smdawson/Wilson2/doc/coupler_5x8.jpg

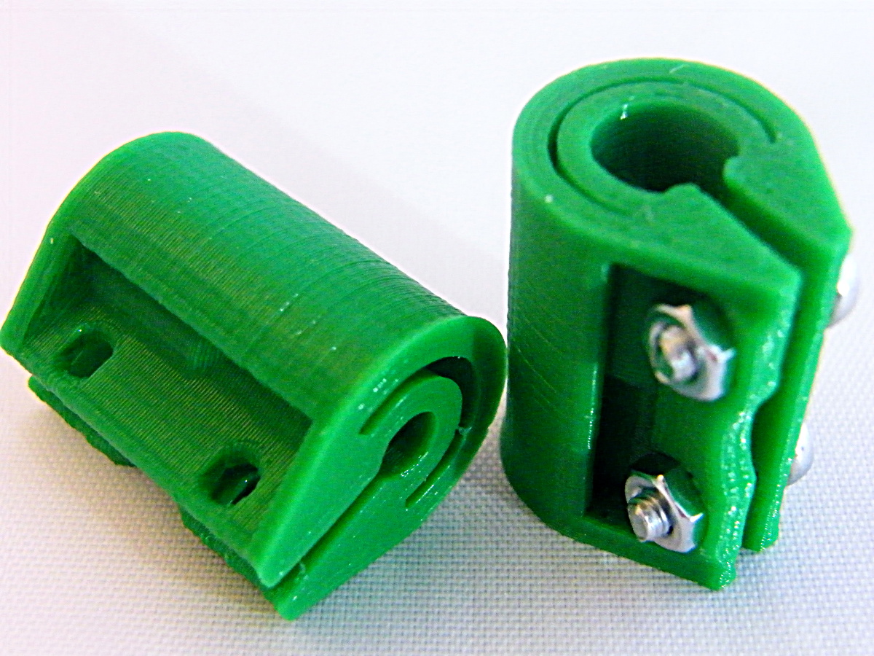
doc/coupler_5x8.jpg
