smdawson/Wilson2/doc/power_assy_1.jpg

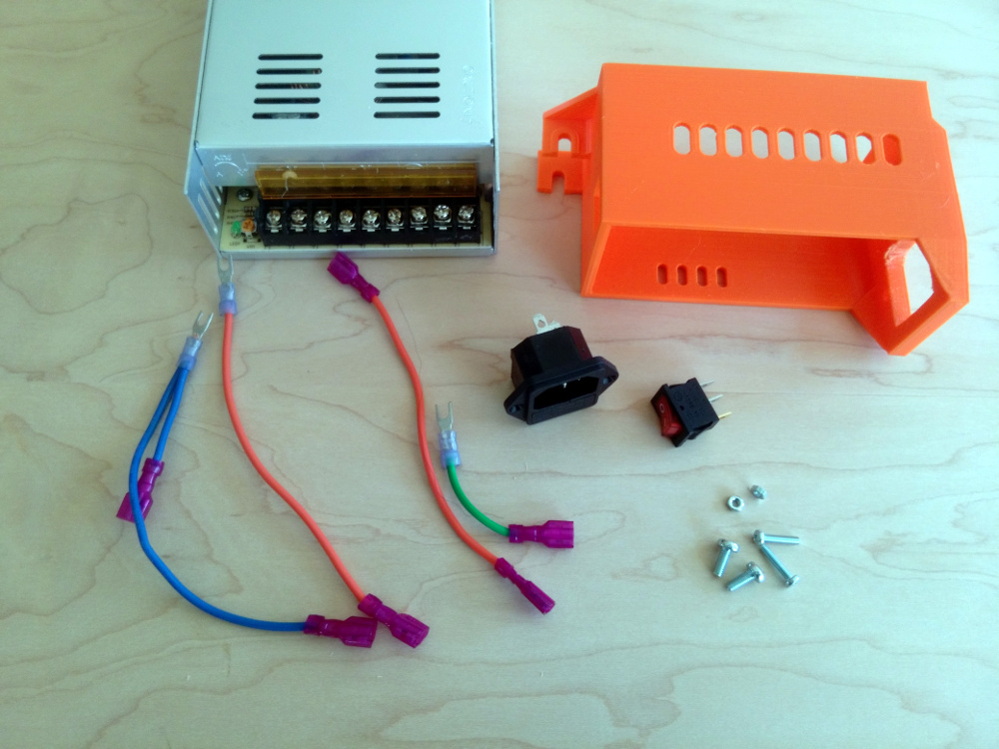
doc/power_assy_1.jpg
