smdawson/Wilson2/stl/alts-and-deprecated/readme.txt

/stl/alts-and-deprecated

The model files located in this folder are for 
rarely used alternate versions of some parts, or
deprecated models (things no longer recommended 
for the standard Wilson II build).
