smdawson/Wilson2/doc/coupler-5x8.png

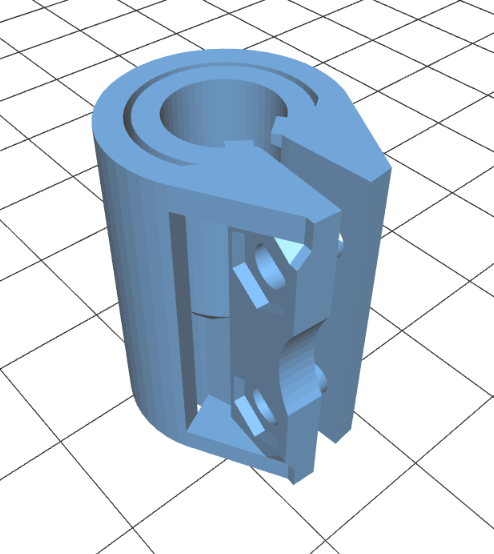
doc/coupler-5x8.png
