smdawson/Wilson2/doc/fanduct-e3dlite6-alt.png

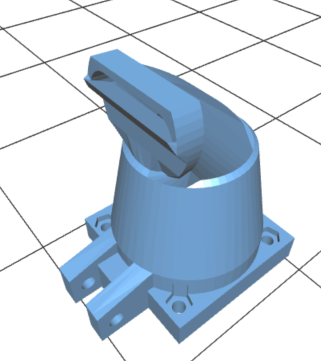
doc/fanduct-e3dlite6-alt.png
