smdawson/Wilson2/doc/power_assy_2.jpg

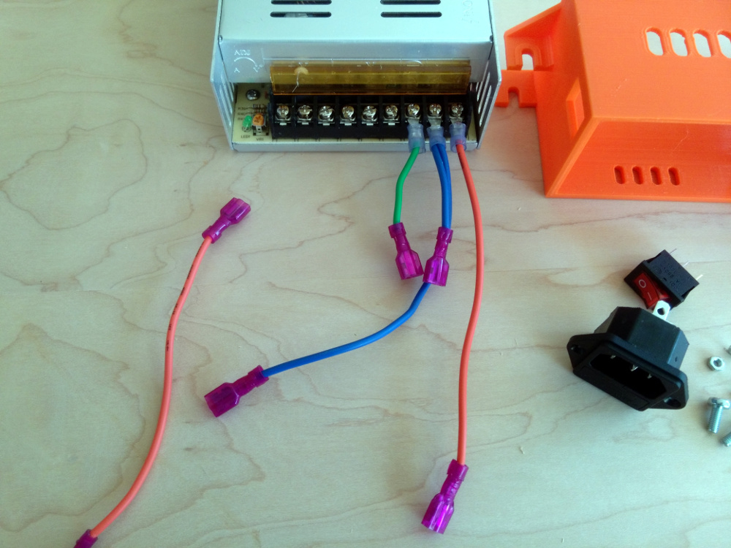
doc/power_assy_2.jpg
