smdawson/Wilson2/doc/power_assy_3.jpg

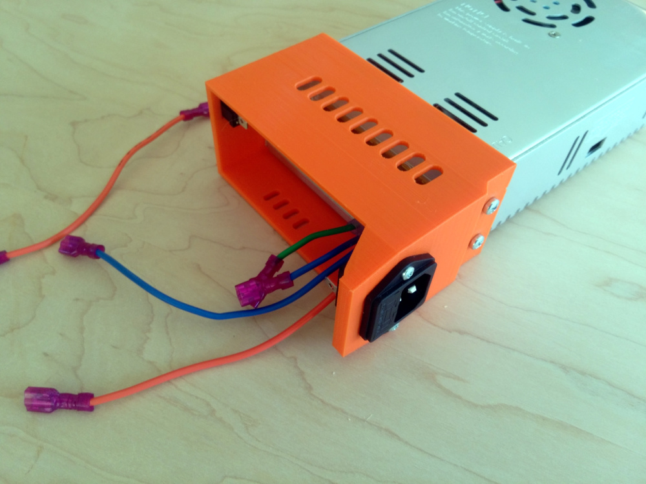
doc/power_assy_3.jpg
