smdawson/Wilson2/doc/power_assy_4.jpg

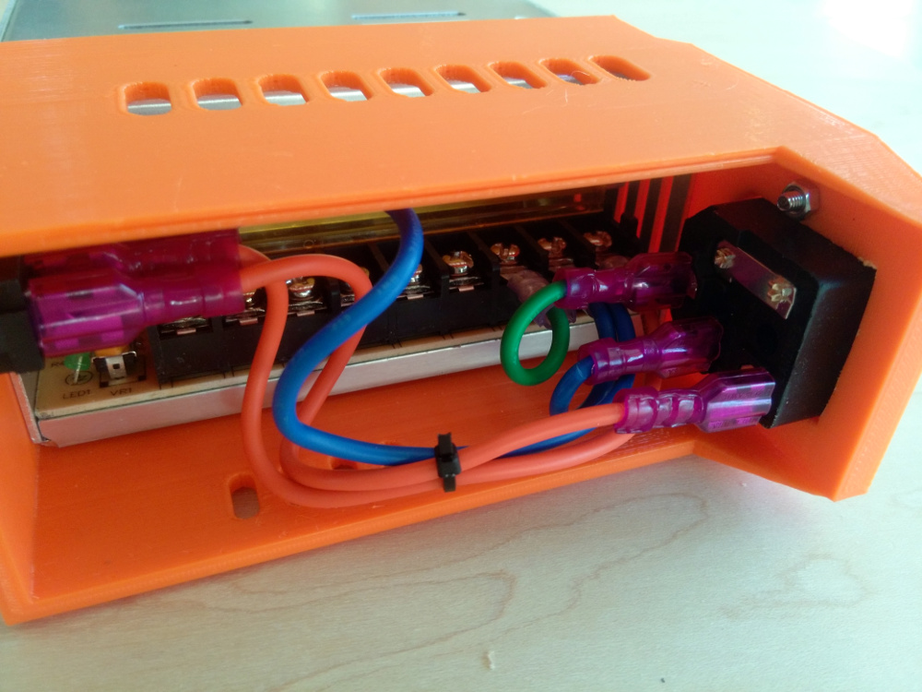
doc/power_assy_4.jpg
