smdawson/Wilson2/doc/power_assy_5.jpg

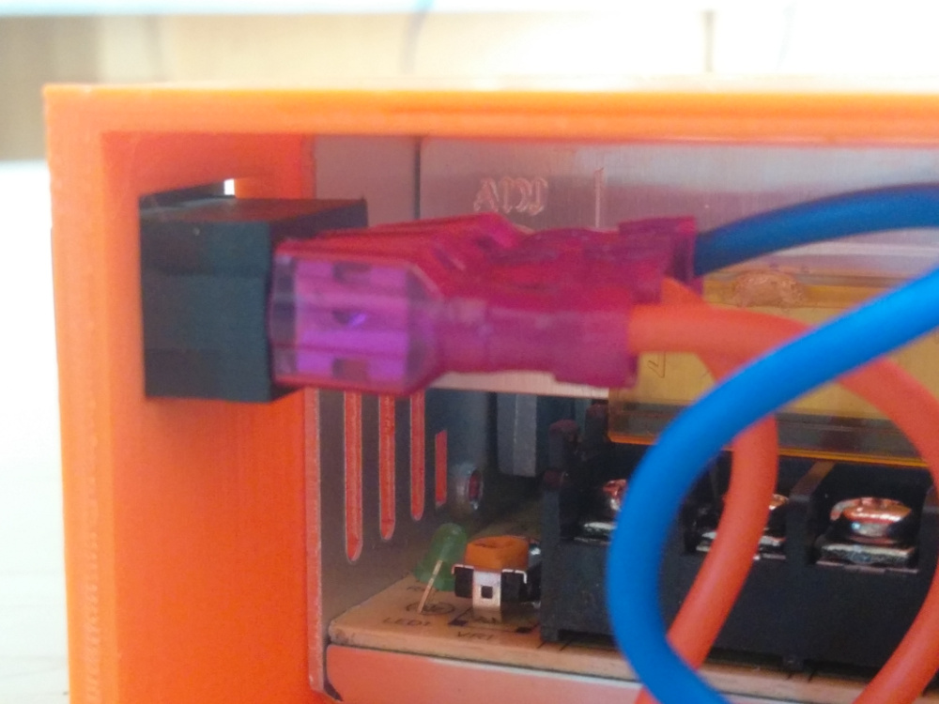
doc/power_assy_5.jpg
