smdawson/Wilson2/doc/power_assy_6.jpg

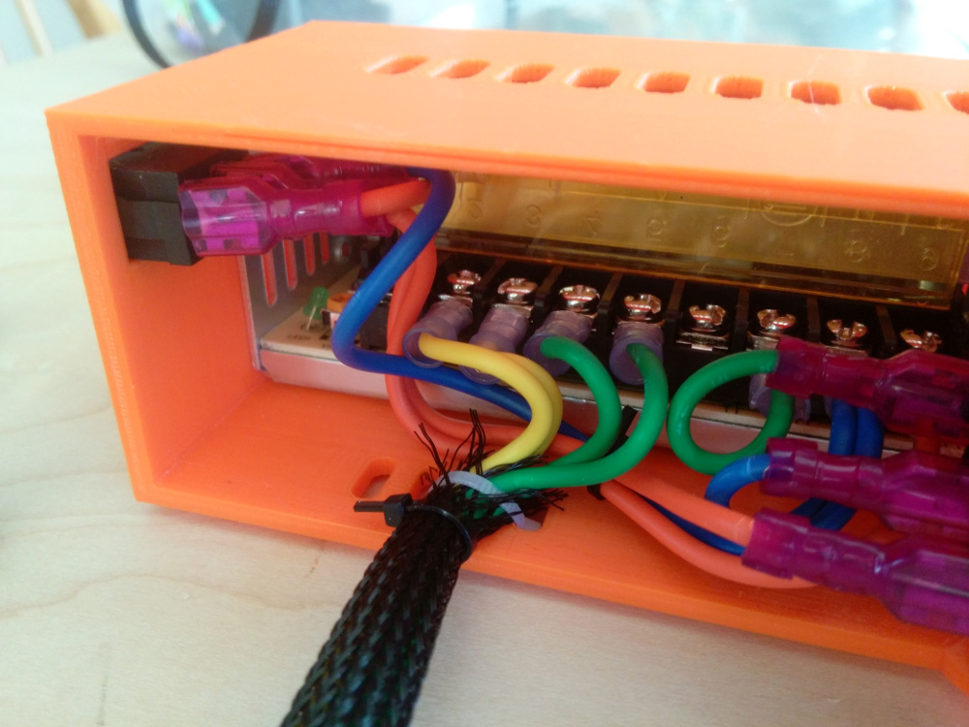
doc/power_assy_6.jpg
