smdawson/Wilson2/doc/power_assy_7.jpg

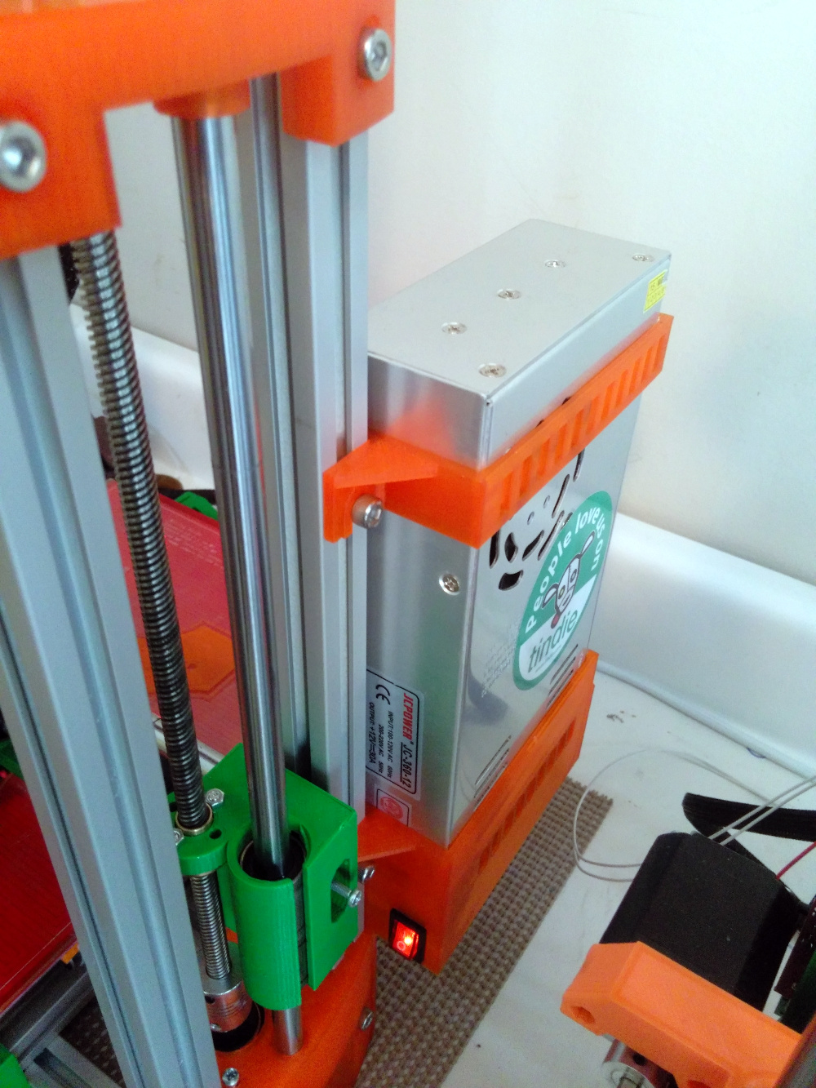
doc/power_assy_7.jpg
