smdawson/Wilson2/doc/psu-mount-bottom.png

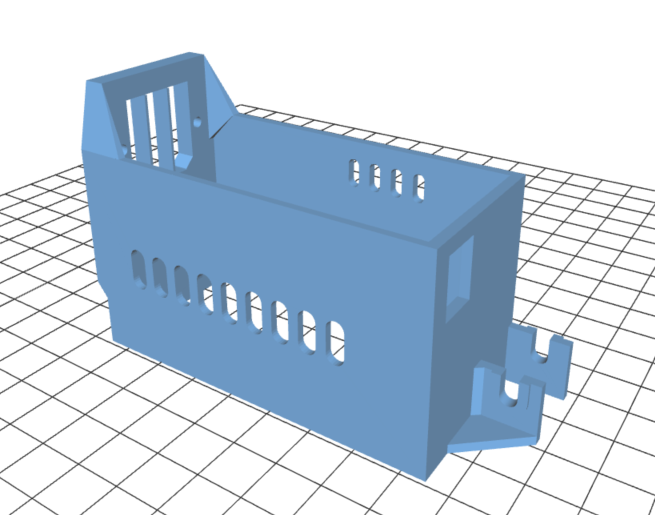
doc/psu-mount-bottom.png
