smdawson/Wilson2/doc/swissclip1.jpg

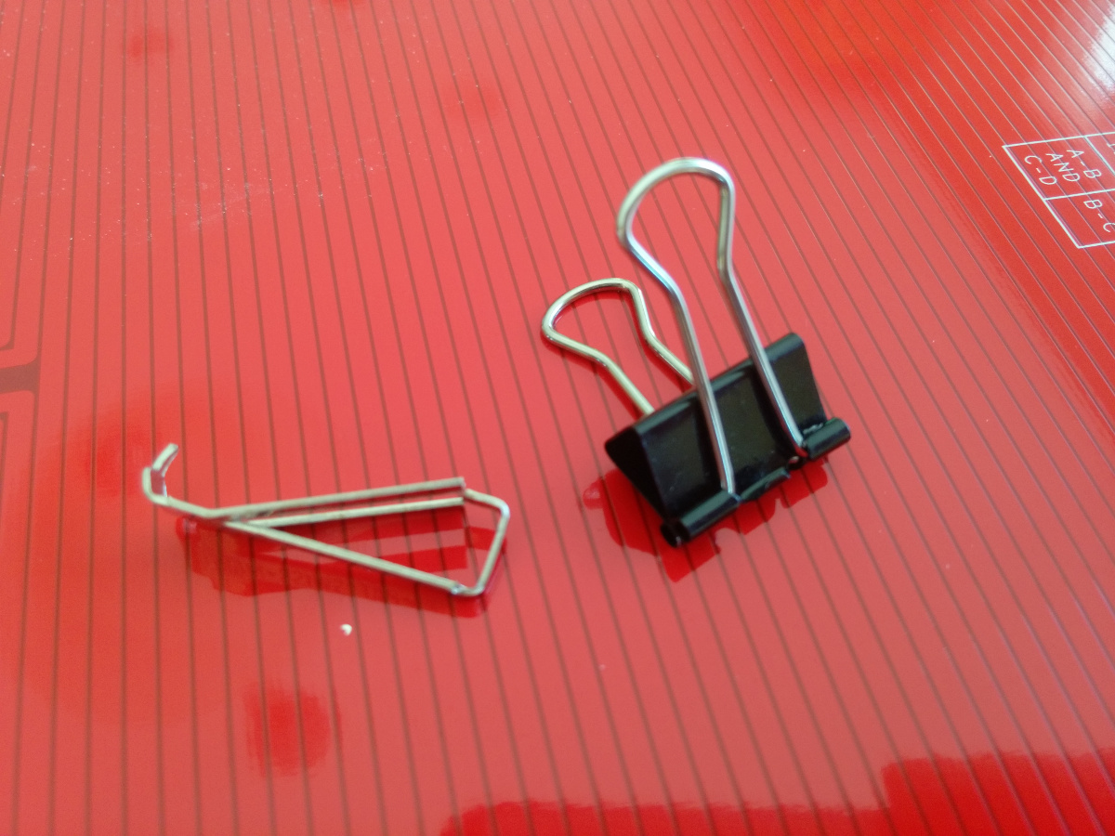
doc/swissclip1.jpg
