smdawson/Wilson2/doc/swissclip2.jpg

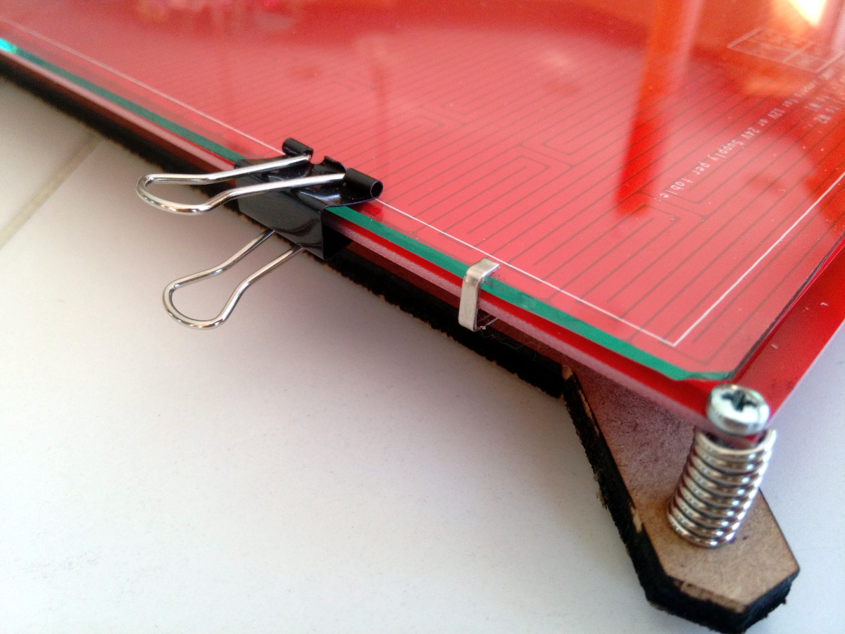
doc/swissclip2.jpg
