smdawson/Wilson2/doc/swissclip3.jpg

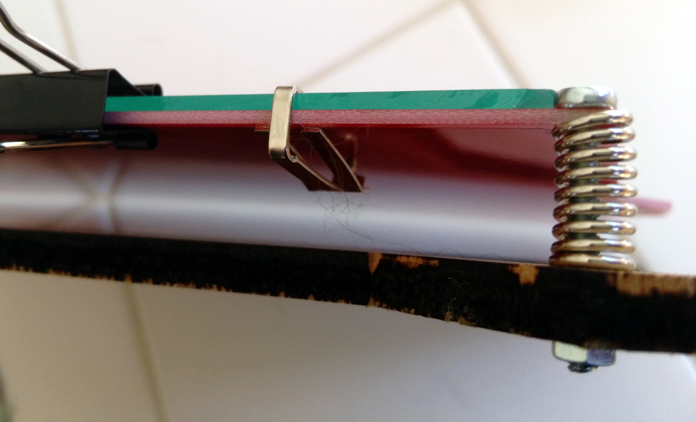
doc/swissclip3.jpg
