smdawson/Wilson2/doc/tensioner_3mm-pulley.jpg

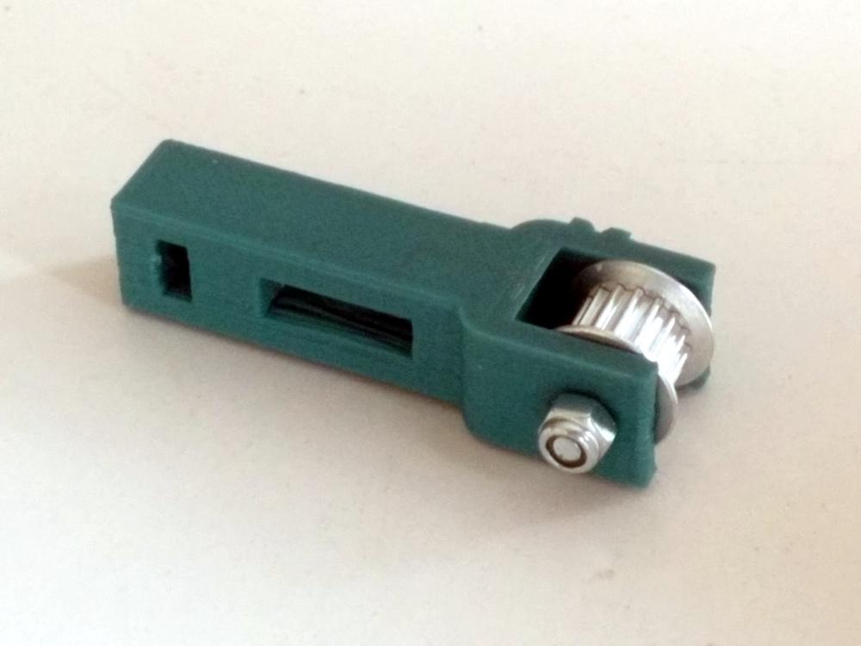
doc/tensioner_3mm-pulley.jpg
