smdawson/Wilson2/doc/x-carriage.png

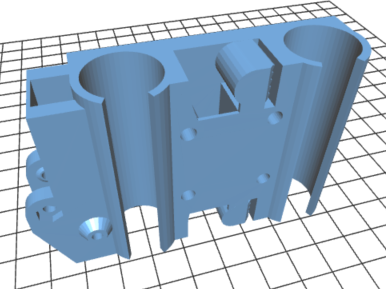
doc/x-carriage.png
