smdawson/Wilson2/doc/x-end-idler.png

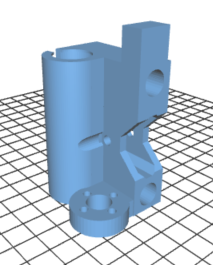
doc/x-end-idler.png
