smdawson/Wilson2/doc/x-end-motor.png

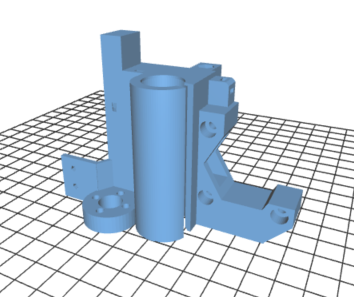
doc/x-end-motor.png
