smdawson/Wilson2/doc/z-lower-brace-1.png

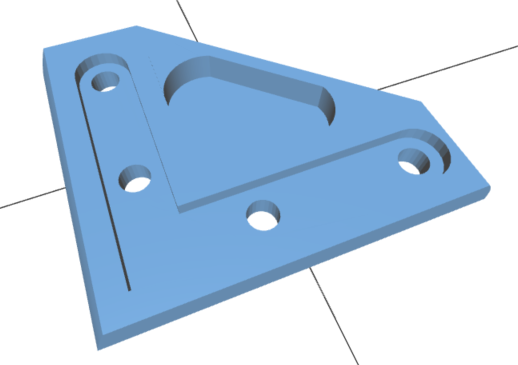
doc/z-lower-brace-1.png
