smdawson/Wilson2/doc/z-lower-brace-2.png

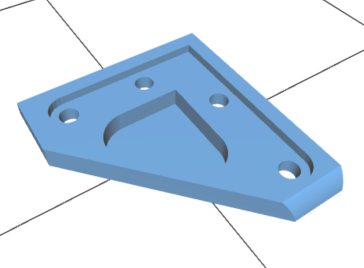
doc/z-lower-brace-2.png
