smdawson/Wilson2/doc/z-rack.png

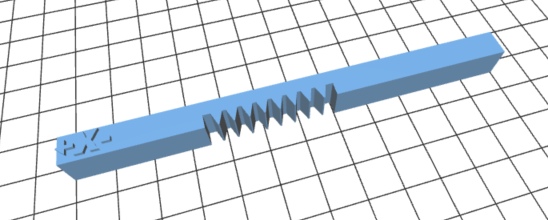
doc/z-rack.png
