smdawson/Wilson2/doc/zrack-animation.gif

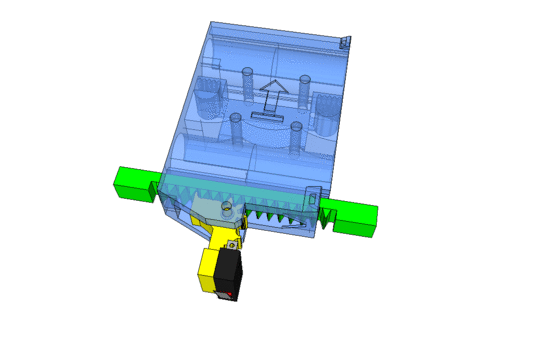
doc/zrack-animation.gif
