smdawson/Wilson2/doc/My_WilsonII_BOM.xlsx

 |  |  |  | Total Cost: |  | $468.68 |  | Total Remaining Cost: |  | $317.40
Item | Quantity | Length / Notes |  | Cost | Source | Part Number | Purchased | Still Need | Total Cost | Remaining Cost
2020 Extrusions
Vertical frame piece (sides) | 4 | 400 | mm |  |  |  | 2 | 2
Horizontal frame piece (top and bottom) | 3 | 330 | mm |  |  |  |  | 3
Y axis frame piece | 2 | 500 | mm |  |  |  | 2 | 0
20mm Single Profile Extrusion | 2 | 72 | in | 17.19 | McMaster Carr | 5537T101 | 1 | 1 | $34.38 | 17.19
2 - 72" sticks will make all needed:
1 for 2 Y axis frames and 2 vertical frame pieces
1 for 3 horizontal frames and 2 vertical frame pieces
M10 Smooth Rods
X-Axis | 2 | 370 | mm | 12.60 | McMaster Carr | 6112K102 |  | 2 | $25.20 | $25.20
Y-Axis | 2 | 500 | mm | 15.07 | McMaster Carr | 6112K47 | 2 | 0 | $30.14 | $0.00
Z-Axis | 2 | 320 | mm | 12.60 | McMaster Carr | 6112K102 |  | 2 | $25.20 | $25.20
Threaded Rods
8mm lead screw | 2 | 300 | mm | 21.99 | Ebay |  |  | 2 | $43.98 | $43.98
Belts & Pulleys
Y axis GT2 timing belt (w=6mm) | 1 | 1030 | mm |  |  |  | 1 | 0
X axis GT2 timing belt (w=6mm) | 1 | 900 | mm |  |  |  | 1 | 0
GT2 pulley | 2 | 16 to 20 | mm |  |  |  | 2 | 0
Pulley & Belt Kit (Includes all above) | 1 |  |  | 6.90 | Ebay |  | 1 | 0 | $6.90 | $0.00
Nuts & Bolts
M5 x 10mm machine screw | 1 | 100/bx need 55 |  | 4.72 | McMaster Carr | 92005A320 | 1 | 0 | $4.72 | $0.00
M5 t slot nut | 55 |  |  | 0.43 | Ebay | 96887A331 | 55 | 0 | $23.48 | $0.00
M4 x 10mm machine screw | 4 |  |  | 0.24 | Home Depot |  | 4 | 0 | $0.96 | $0.00
M4 x 20mm machine screw | 4 |  |  | 0.12 | Mr Metric | M31072 |  | 4 | $0.48 | $0.48
M4 x 25mm machine screw | 4 |  |  | 0.08 | JDC | 99-79610879 |  | 4 | $0.32 | $0.32
M4 hex nut | 6 |  |  | 0.18 | Home Depot |  | 6 | 0 | $1.11 | $0.00
M4 lock nut | 2 |  |  | 0.18 | Home Depot |  | 2 | 0 | $0.37 | $0.00
M3 x 10mm machine screw | 12 |  |  | 0.02 | Mr Metric | M31047 |  | 12 | $0.24 | $0.24
M3 x 14mm machine screw | 19 |  |  | 0.04 | Mr Metric | M31050 |  | 19 | $0.76 | $0.76
M3 x 25mm machine screw | 6 |  |  | 0.03 | Mr Metric | M31056 |  | 6 | $0.18 | $0.18
M3 x 30mm machine screw | 6 |  |  | 0.05 | Mr Metric | M31057 |  | 6 | $0.30 | $0.30
M3 x 60mm machine screw | 2 |  |  | 3.44 | Mr Metric | M10067 |  | 2 | $6.88 | $6.88
M3 hex nut | 22 |  |  | 0.02 | Mr Metric | M50013 |  | 22 | $0.44 | $0.44
M3 lock nut | 5 |  |  | 0.02 | Mr Metric | M50303 |  | 5 | $0.10 | $0.10
M3 washer | 10 |  |  | 0.01 | Mr Metric | M60010 |  | 10 | $0.10 | $0.10
M2 x 16mm machine screw | 9 |  |  | 0.04 | Mr Metric | M31011 |  | 9 | $0.36 | $0.36
M2 hex nut | 9 |  |  | 0.10 | Mr Metric | M50006 |  | 9 | $0.90 | $0.90
Printed Parts – Required
Printed Parts Kit (Includes Required & Recommended) | 1 |  | x | 50.00 | Tindie |  | 1 | 0 | $50.00 | $0.00
X end idler | 1 |  | x |  |  |  | 1 | 0
X end motor | 1 |  | x |  |  |  | 1 | 0
X carriage | 1 |  | x |  |  |  | 1 | 0
X belt tensioner | 1 |  | x |  |  |  | 1 | 0
Y end idler | 1 |  | x |  |  |  | 1 | 0
Y belt tensioner | 1 |  | x |  |  |  | 1 | 0
Y end motor | 1 |  | x |  |  |  | 1 | 0
Y table mount | 1 |  | x |  |  |  | 1 | 0
Z motor holder, left | 1 |  | x |  |  |  | 1 | 0
Z motor holder, right | 1 |  | x |  |  |  | 1 | 0
Z top frame, left | 1 |  | x |  |  |  | 1 | 0
Z top frame, right | 1 |  | x |  |  |  | 1 | 0
Z lower corner brace, front/right, back/left | 2 |  | x |  |  |  | 2 | 0
Z lower corner brace, front/left, back/right | 2 |  | x |  |  |  | 2 | 0
Y frame brace | 4 |  | x |  |  |  | 4 | 0
Idler bearing guide (two parts makes one guide) | 4 |  | x |  |  |  | 4 | 0
Extruder body / idler / hot end clamp set | 1 |  | x |  |  |  | 1 | 0
Servo mount | 1 |  | x |  |  |  | 1 | 0
Servo endstop mount | 1 |  | x |  |  |  | 1 | 0
Extruder fan duct | 1 |  | x |  |  |  | 1 | 0
Printed Parts – Recommended
Electronics frame mount (for RAMPS) | 1 |  | x |  |  |  | 1 | 0
Filament spool support (two pieces) | 1 |  | x |  |  |  | 1 | 0
SMART display frame mount (one piece) | 1 |  | x |  |  |  | 1 | 0
12V PSU frame mounting bracket | 2 |  | x |  |  |  | 2 | 0
Power switch mount | 1 |  | x |  |  |  | 1 | 0
Everything Else
NEMA17 Stepper motor | 5 |  |  | 0 |  |  | 5 | 0 |  |  | Salvaged
MDF board (heated bed mount) | 1 | 1/4" -2'X2' |  | 3.92 | Home Depot | 1001283607 | 1 | 0 | $3.92 | $0.00
Heat bed PCB | 1 |  |  | 47.99 | Ebay |  |  | 1 | $47.99 | $47.99
Heat bed thermistor | 1 |  |  |  |  |  |  | 1
3mm borosilicate or picture frame glass | 1 |  |  |  |  |  |  | 1
Controller (Mega/RAMPS, Rambo, etc) | 1 |  |  | 29.99 | Ebay |  |  | 1 | $29.99 | $29.99
SMART lcd controller / SD reader | 1 |  |  | 19.99 | Ebay |  |  | 1 | $19.99 | $19.99
Endstop (limit) switch | 3 |  |  | 1.83 | Newark | 36K7637 |  | 3 | $5.49 | $5.49
Micro servo (9g type) | 1 |  |  | 4.99 | Ebay |  |  | 1 | $4.99 | $4.99
LM10UU linear bearing | 12 |  |  | 1.04 | Ebay | LM10UU | 12 | 0 | $12.48 | $0.00
608ZZ roller bearing | 2 |  |  | 0.00 | JDC | 96-608-ZZ-EMQ | 2 | 0 |  |  | Salvaged
624RS roller bearing | 3 |  |  |  |  |  |  | 3
MK7 Drive gear (or similar) | 1 |  |  | 6.2 | Ebay |  |  | 1 | $6.20 | $6.20
Brass or delrin lead screw nut | 2 |  |  |  |  |  |  | 2
5mm to 8mm flexible shaft couplers | 2 |  |  | 4.84 | Ebay |  |  | 2 | $9.68 | $9.68
40mm x 40mm x 10mm fan - 12V | 1 |  |  | 4.69 | Ebay |  |  | 1 | $4.69 | $4.69
80mm x 80mm x 10mm fan | 1 |  |  | 3.49 | Ebay |  |  | 1 | $3.49 | $3.49
Miniature zip ties | 20 |  |  | $0 |  |  | 20 | 0 |  |  | Already Own
Extruder idler springs | 2 | High tension, 1” unsprung length, >3mm ID |  |  |  |  |  | 2
Bed leveling springs | 4 | Lower tension is OK, 1” unsprung, ID > 3mm |  |  |  |  | 4 | 0 |  |  | Salvaged
Power Supply | 1 |  |  | 19.99 | Ebay |  |  | 1 | $19.99 | $19.99
E2d v6 Hot end Lite | 1 |  |  | 37.99 | Filastruder |  |  | 1 | $37.99 | $37.99
Power switch KCD1-104N (12mm x 19mm body) | 1 |  |  | 4.28 | Ebay |  |  | 1 | $4.28 | $4.28
 |  |  |  |  |  |  |  |  | $468.68 | $317.40
