smdawson/Wilson2/doc/wilson-bed-2030-lc-2pass-2up.dxf

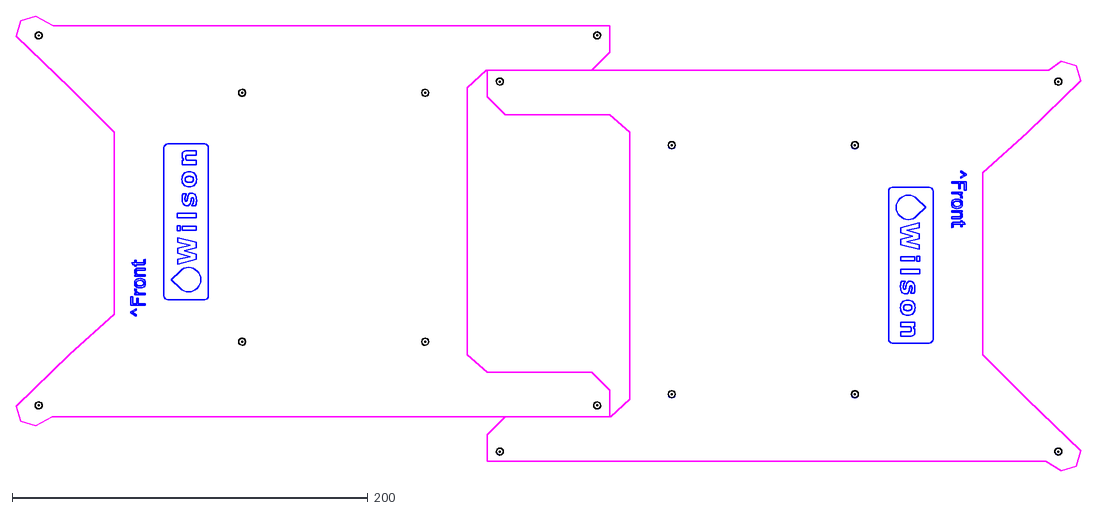
[picture p23: CAD file, 2019-02-19]
doc/wilson-bed-2030-lc-2pass-2up.dxf
598.4 x 255.3
