smdawson/Wilson2/scad/motor.stl

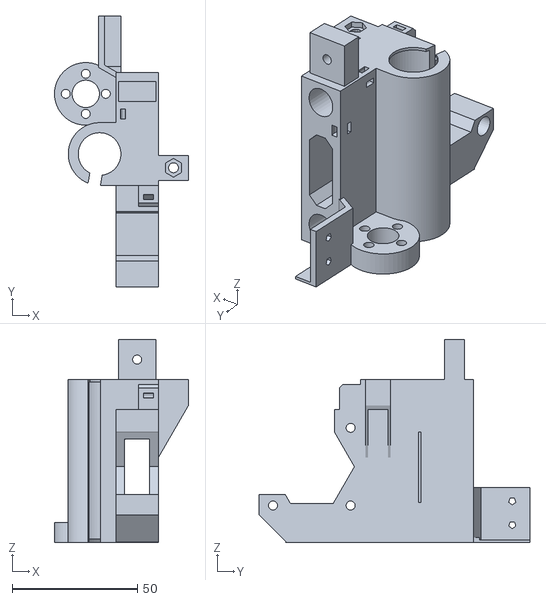
[picture p24: CAD file, 2019-02-19]
scad/motor.stl
53.5 x 108.0 x 81.0
