smdawson/Wilson2/stl/x-end-idler.stl

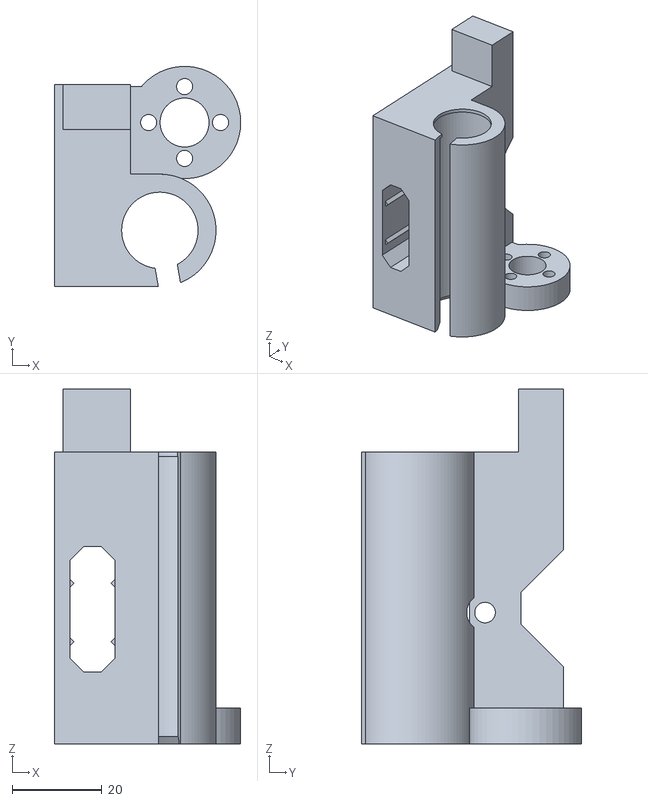
[picture p25: CAD file, 2019-02-19]
stl/x-end-idler.stl
41.5 x 49.0 x 79.0
