smdawson/Wilson2/doc/wilson-bed-2030-lc-2pass.dxf

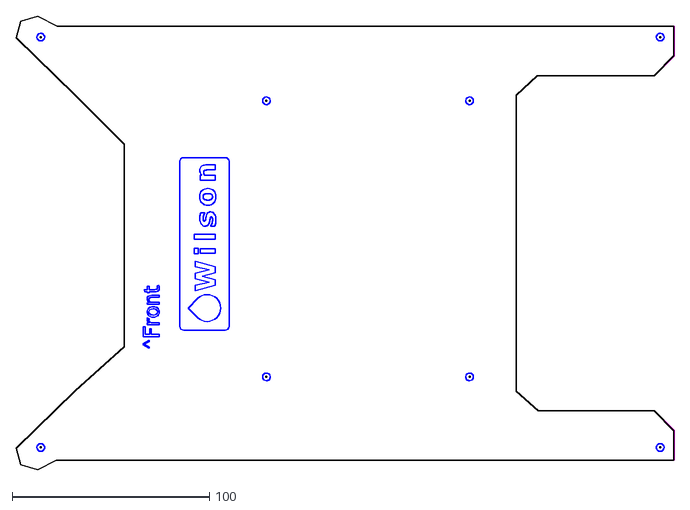
[picture p26: CAD file, 2019-02-19]
doc/wilson-bed-2030-lc-2pass.dxf
333.6 x 230.0
