smdawson/Wilson2/scad/rack_and_pinion.stl

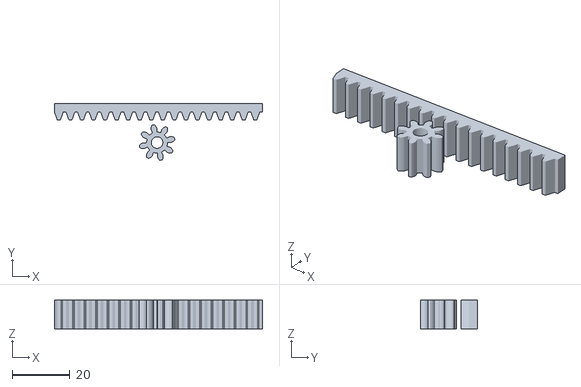
[picture p27: CAD file, 2019-02-19]
scad/rack_and_pinion.stl
72.0 x 19.7 x 10.0
