smdawson/Wilson2/stl/y-idler.stl

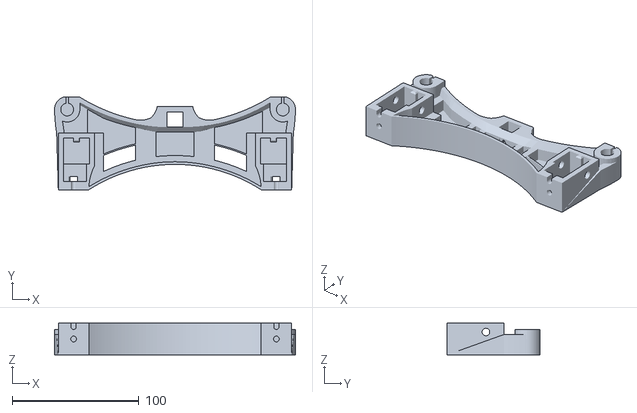
[picture p28: CAD file, 2019-02-19]
stl/y-idler.stl
190.0 x 73.0 x 25.0
