smdawson/Wilson2/doc/#wilson-bed-2030-lc.dxf

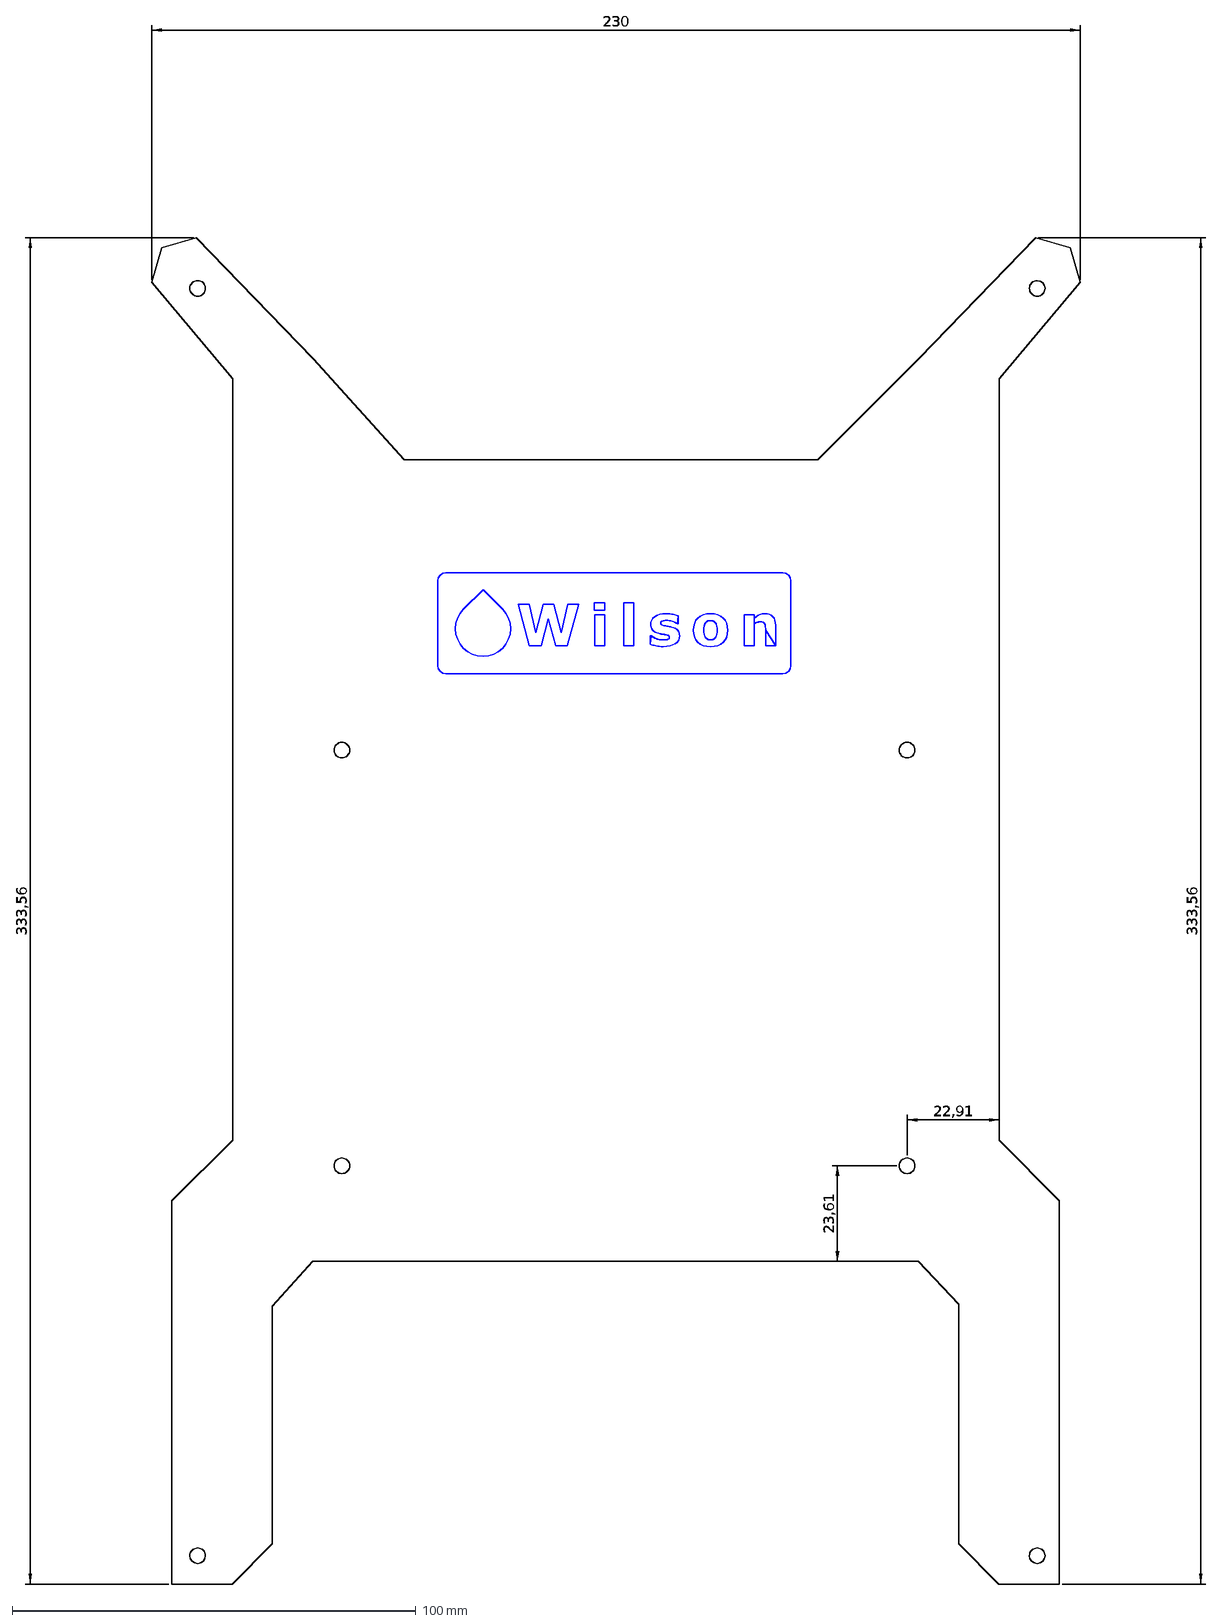
[picture p29: CAD file, 2016-03-01]
doc/#wilson-bed-2030-lc.dxf
230
333,56
23,61
22,91
