smdawson/Wilson2/stl/z-rack.stl

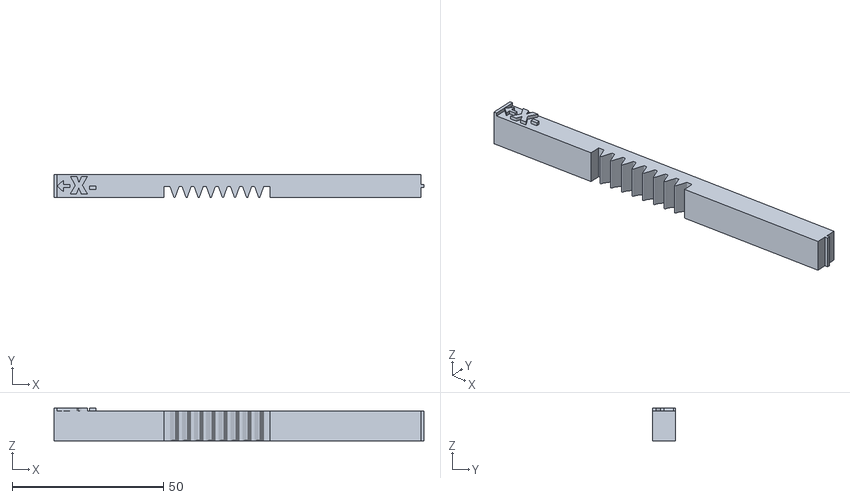
[picture p30: CAD file, 2019-02-19]
stl/z-rack.stl
122.3 x 7.67 x 10.8
