smdawson/Wilson2/stl/y-motor.stl

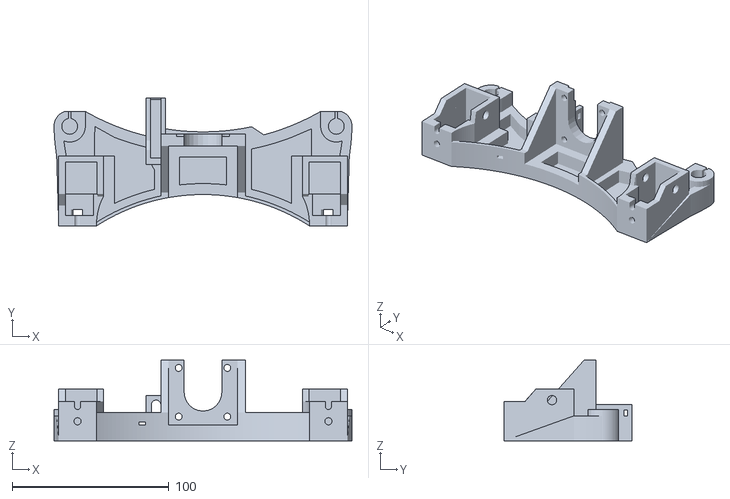
[picture p31: CAD file, 2019-02-19]
stl/y-motor.stl
190.0 x 81.5 x 51.5
