smdawson/Wilson2/stl/x-end-motor.stl

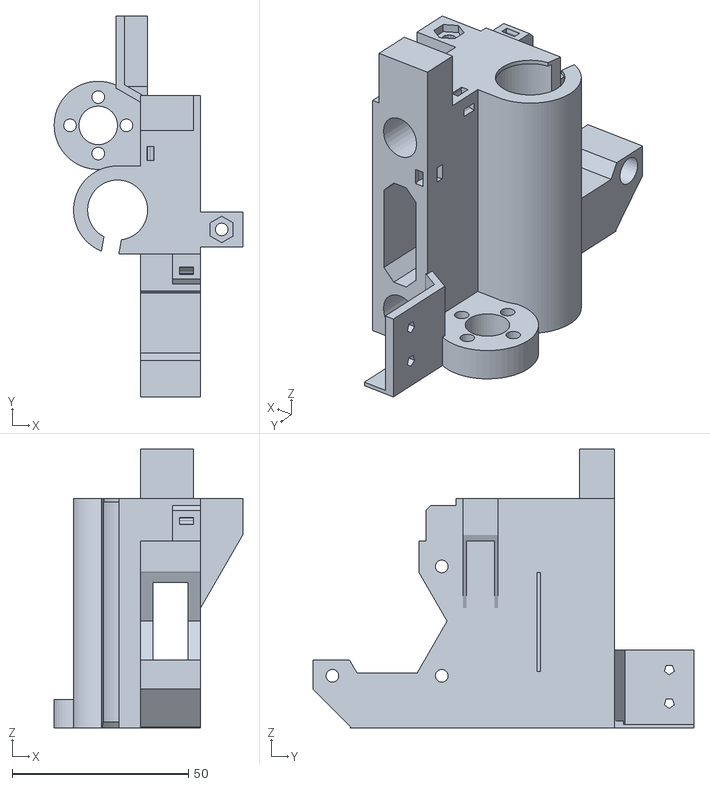
[picture p32: CAD file, 2019-02-19]
stl/x-end-motor.stl
53.5 x 108.0 x 79.0
