smdawson/Wilson2/stl/y-table-10.stl

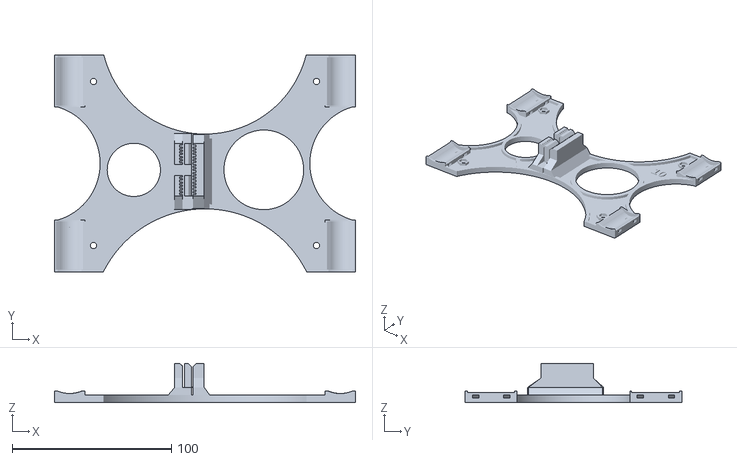
[picture p33: CAD file, 2019-02-19]
stl/y-table-10.stl
189.0 x 136.1 x 24.5
