smdawson/Wilson2/stl/z-motor-right.stl

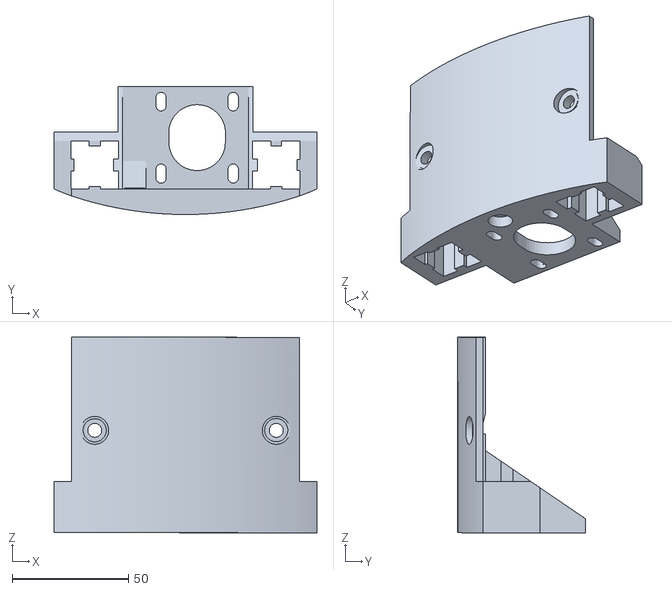
[picture p34: CAD file, 2019-02-19]
stl/z-motor-right.stl
113.0 x 55.0 x 84.0
