smdawson/Wilson2/stl/psu-mount.stl

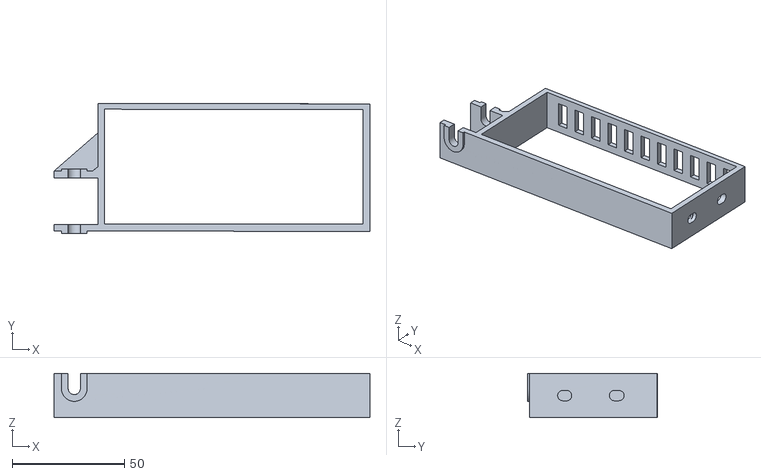
[picture p35: CAD file, 2019-02-19]
stl/psu-mount.stl
140.5 x 57.7 x 19.6
