smdawson/Wilson2/stl/x-tensioner.stl

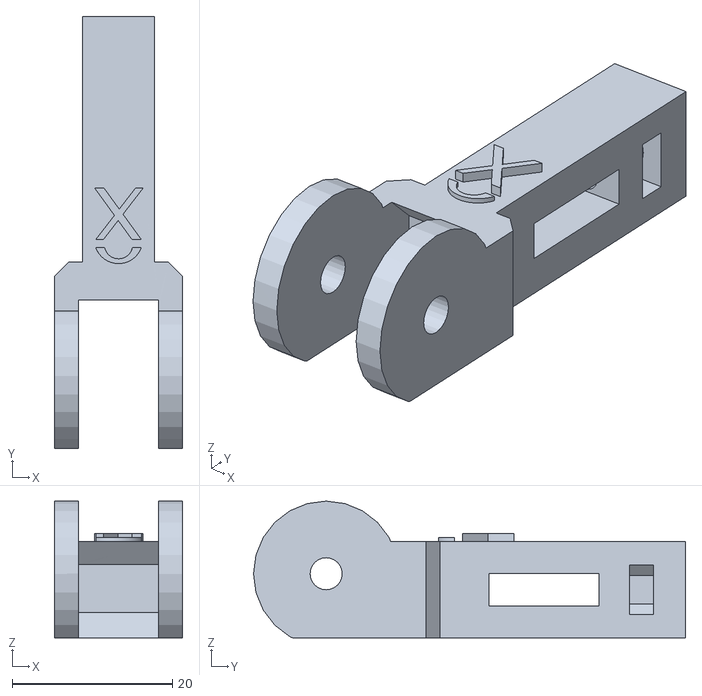
[picture p36: CAD file, 2019-02-19]
stl/x-tensioner.stl
16.0 x 53.9 x 17.1
