smdawson/Wilson2/stl/psu-mount-bottom.stl

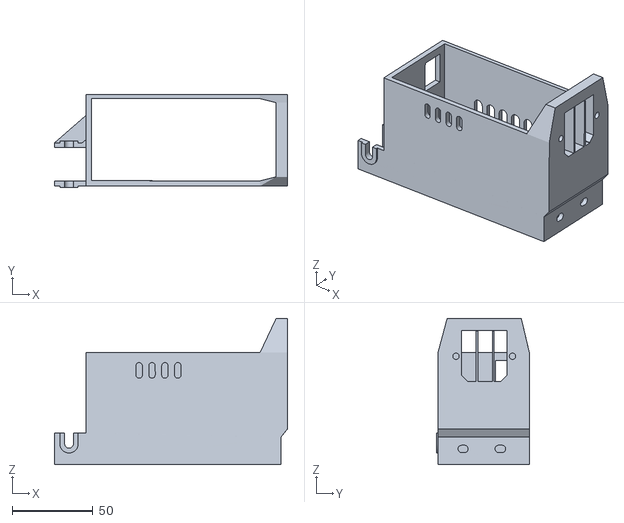
[picture p37: CAD file, 2019-02-19]
stl/psu-mount-bottom.stl
144.6 x 57.7 x 90.8
