smdawson/Wilson2/stl/x-carriage.stl

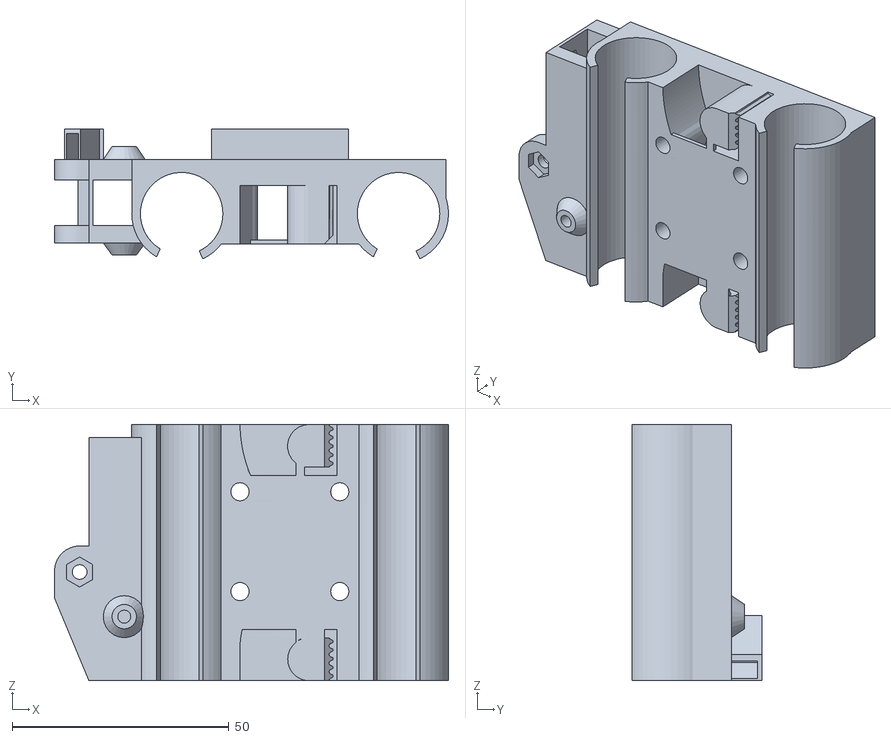
[picture p38: CAD file, 2019-02-19]
stl/x-carriage.stl
90.8 x 29.9 x 59.0
