smdawson/Wilson2/stl/y-tensioner.stl

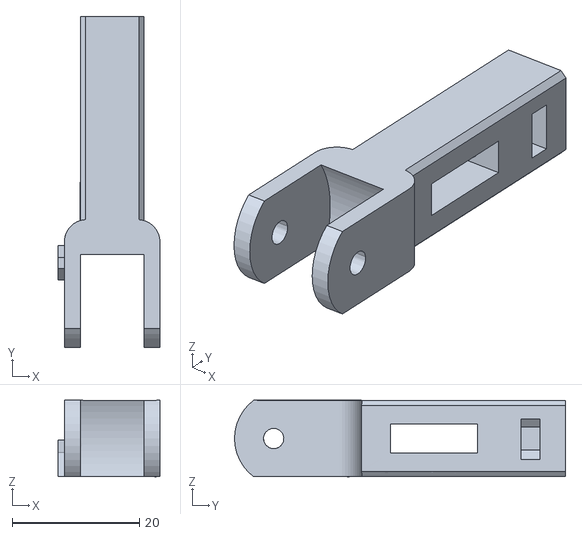
[picture p39: CAD file, 2019-02-19]
stl/y-tensioner.stl
16.0 x 52.0 x 12.0
