smdawson/Wilson2/stl/pica-mount.stl

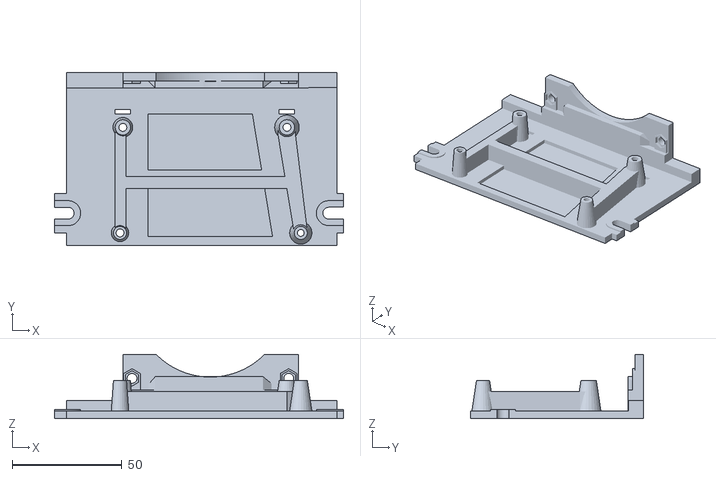
[picture p40: CAD file, 2019-02-19]
stl/pica-mount.stl
131.9 x 79.0 x 29.4
