smdawson/Wilson2/stl/extruder-direct-drive.stl

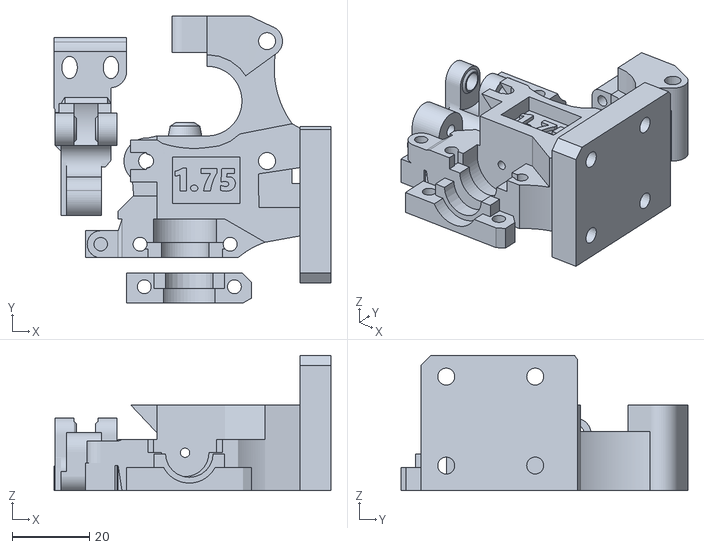
[picture p41: CAD file, 2019-02-19]
stl/extruder-direct-drive.stl
71.5 x 74.2 x 35.0
