smdawson/Wilson2/(list of files, cad)

Other CAD files:
scad/write/knewave.dxf
scad/write/BlackRose.dxf
scad/write/Letters.dxf
scad/write/braille.dxf
scad/write/orbitron.dxf
stl/z-motor-left.stl
scad/rack_and_pinion.scad
scad/pica_mount.scad
scad/ruler.scad
scad/x-end.scad
doc/wilson-bed-2030-lc.dxf
scad/write/TestFont.scad
scad/write/TestSurfaceText.scad
scad/write/TestWrite.scad
scad/write/TestWriteCube.scad
scad/write/TestWriteCylinder.scad
scad/write/TestWriteSphere.scad
scad/write/Write-1.scad
scad/write/Write.scad
sketchup/coupler-5x8.skp
sketchup/extruder_body.skp
sketchup/extruder_clamp.skp
sketchup/extruder_idler.skp
sketchup/filament_mount_left.skp
sketchup/filament_mount_right.skp
sketchup/grouped_etc/old-xend-rack-adapter.skp
sketchup/grouped_etc/psu-mounts.skp
sketchup/grouped_etc/servo_mount.skp
sketchup/grouped_etc/xcarriage-rack-pinion.skp
sketchup/grouped_etc/xy-tensioners-wide.skp
sketchup/grouped_etc/xy-tensioners.skp
sketchup/grouped_etc/z-top-bottom.skp
sketchup/pica-mount.skp
sketchup/psu_mount_bottom.skp
sketchup/psu_mount_top.skp
sketchup/shaft-coupler-5x8.skp
sketchup/smartlcd_mount.skp
sketchup/x_carriage.skp
sketchup/x_tensioner.skp
sketchup/y_brace.skp
sketchup/y_idler.skp
sketchup/y_motor.skp
sketchup/y_table_10.skp
sketchup/y_tensioner.skp
sketchup/z_brace_1.skp
sketchup/z_brace_2.skp
sketchup/z_motor_left.skp
sketchup/z_motor_right.skp
sketchup/z_pinion.skp
sketchup/z_rack.skp
sketchup/z_top_left.skp
sketchup/z_top_right.skp
stl/alts-and-deprecated/extruder-direct-drive-3mm.stl
stl/alts-and-deprecated/extruder-direct-drive-3mmbody.stl
stl/alts-and-deprecated/fanduct-conical.stl
stl/alts-and-deprecated/fanduct-e3dlite6-alt.stl
stl/alts-and-deprecated/fanduct-minimalist.stl
stl/alts-and-deprecated/lm2596-mount.stl
stl/alts-and-deprecated/old-xend-rack-adapter.stl
stl/alts-and-deprecated/power-switch-mount-Cherry-CR_E.stl
stl/alts-and-deprecated/power-switch-mount.stl
stl/alts-and-deprecated/servo-endstop-holder.stl
stl/alts-and-deprecated/servo_mount.stl
stl/alts-and-deprecated/x-tensioner-3mm.stl
stl/alts-and-deprecated/xy-tensioners-wide.stl
stl/alts-and-deprecated/y-tensioner-3mm.stl
