smdawson/Wilson2/doc/wilson-ii-partsguide.odt

Wilson II Printed parts guide

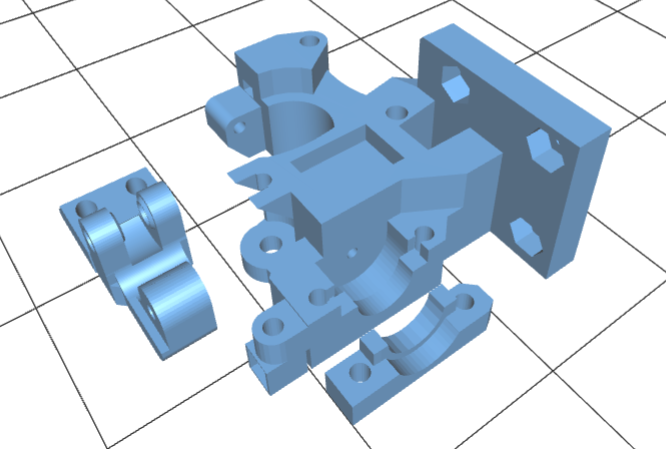
[picture p42: figure]

Extruder-direct-drive.stl (3 pieces)

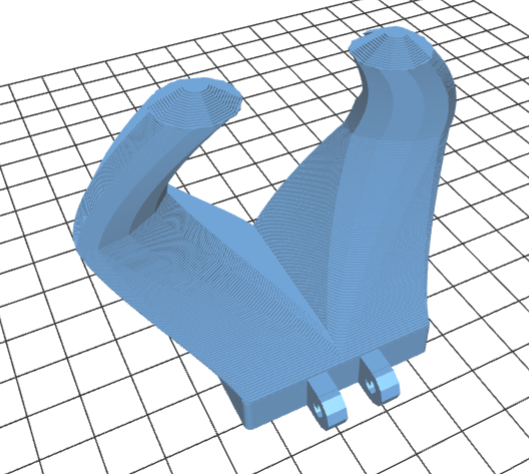
[picture p43: figure]

Fanduct-e3dlite6.stl

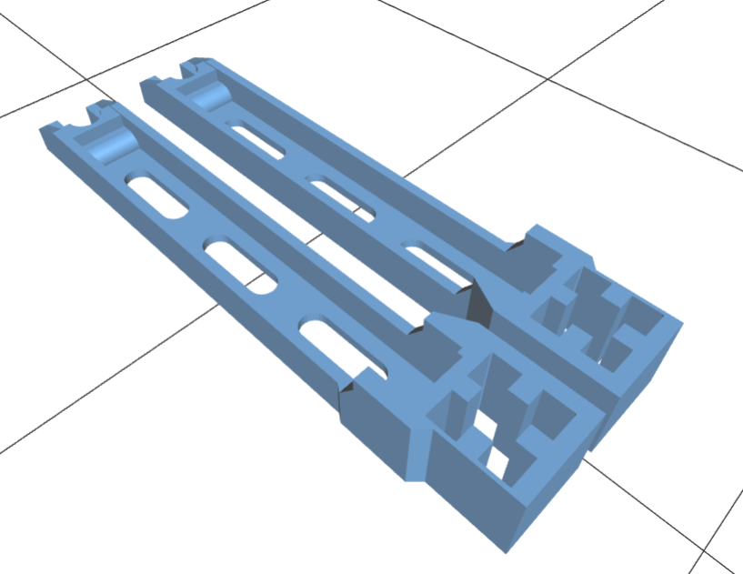
[picture p44: figure]

Filament-mount.stl (2 pieces)

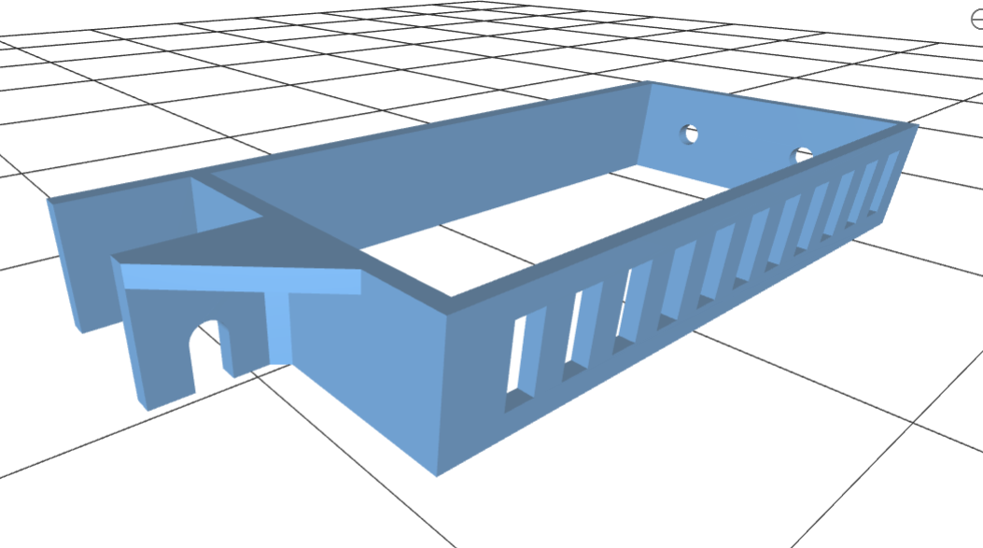
[picture p45: figure]

Psu-mount.stl (1)


Psu-mount-bottom.stl (1)

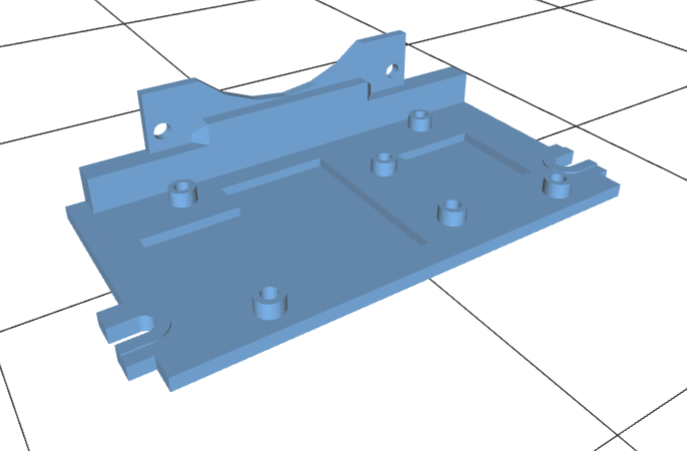
[picture p46: figure]

Ramps-mount.stl (or pica-mount.stl)

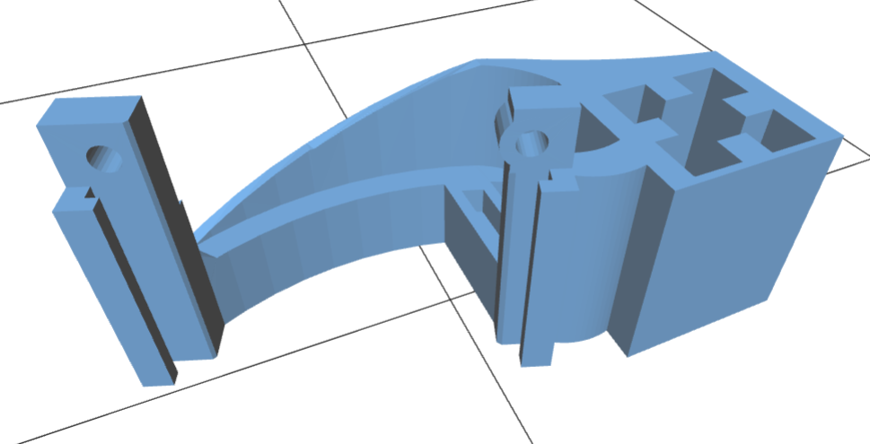
[picture p47: figure]

Smartlcd-mount.stl


X-carriage.stl


X-end-idler.stl


X-end-motor.stl

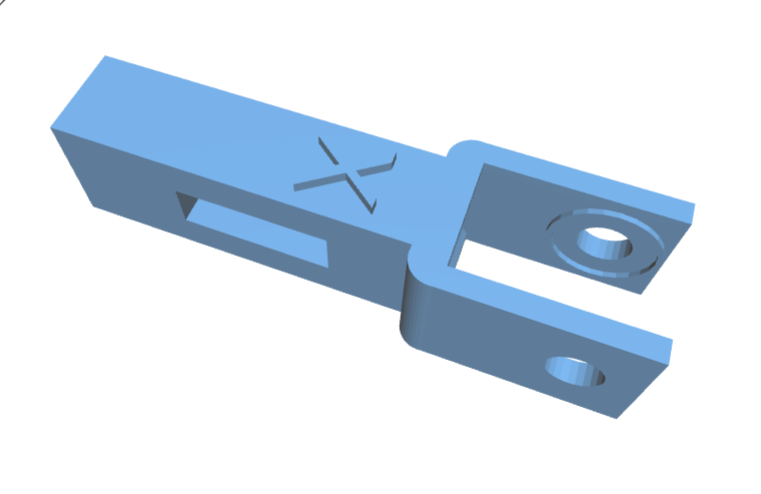
[picture p48: figure]

X-tensioner.stl

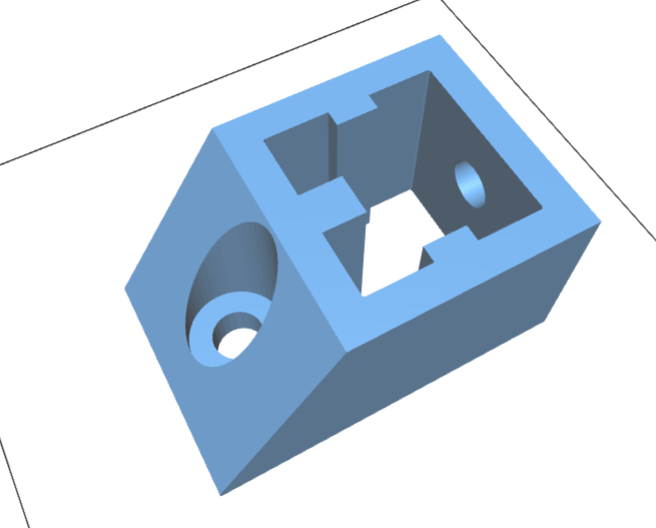
[picture p49: figure]

Y-brace.stl (4)

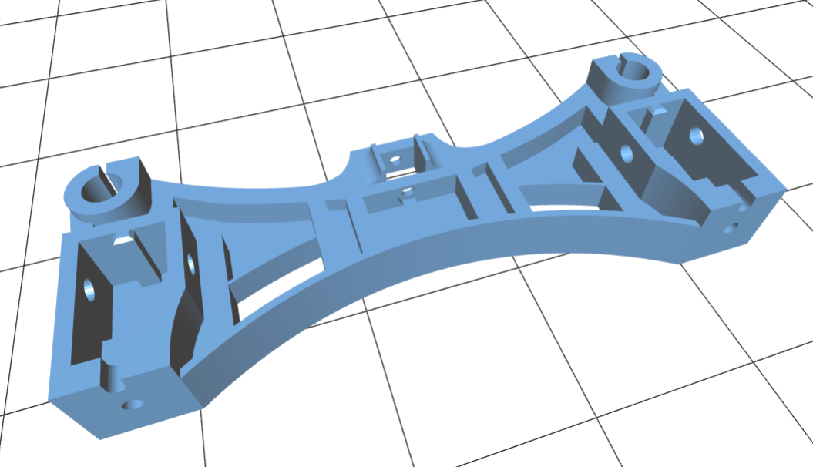
[picture p50: figure]

Y-idler.stl

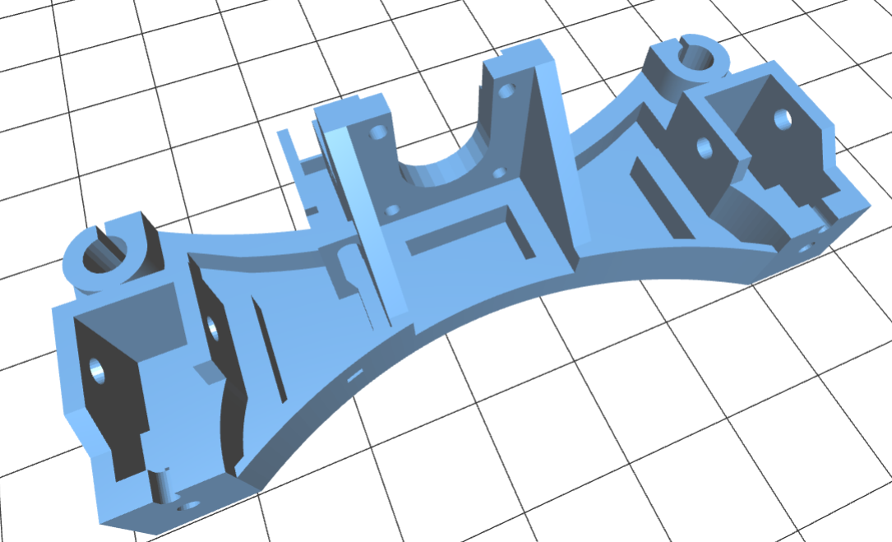
[picture p51: figure]

Y-motor.stl

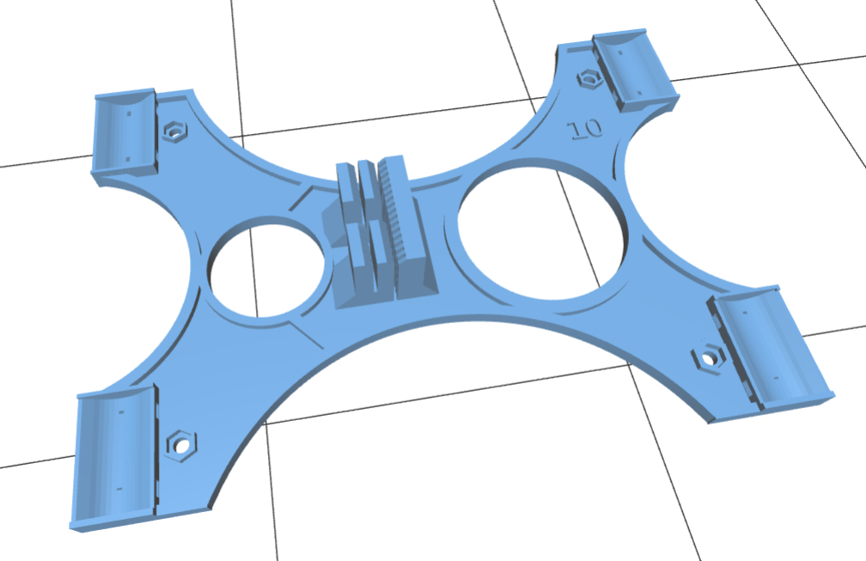
[picture p52: figure]

Y-table-10.stl

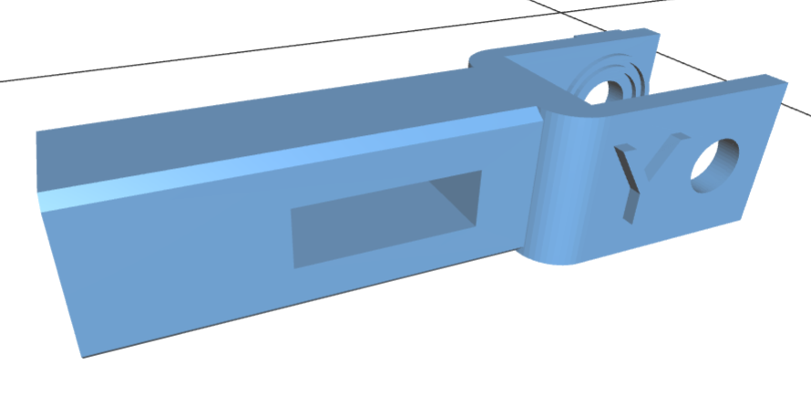
[picture p53: figure]

Y-tensioner.stl


Z-lower-brace-1.stl (2)


Z-lower-brace-2.stl (2)

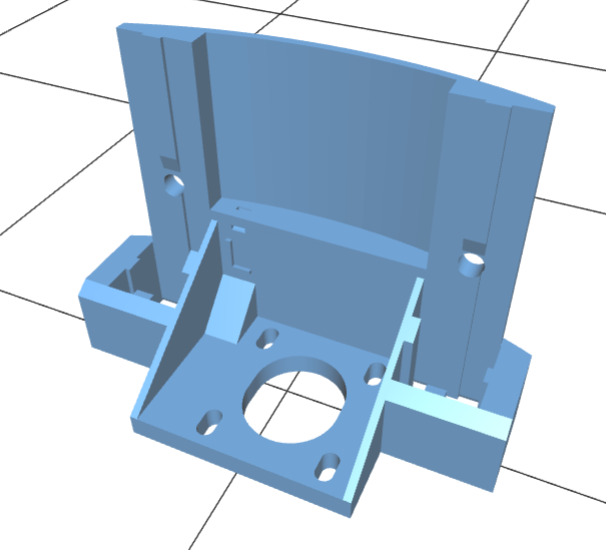
[picture p54: figure]

Z-motor-left.stl

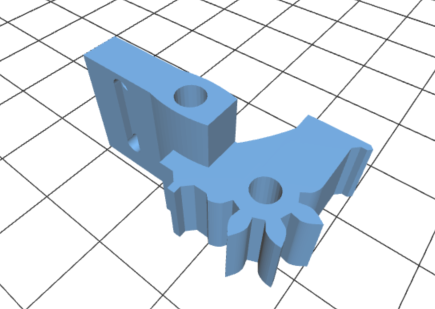
[picture p55: figure]

Z-pinion.stl

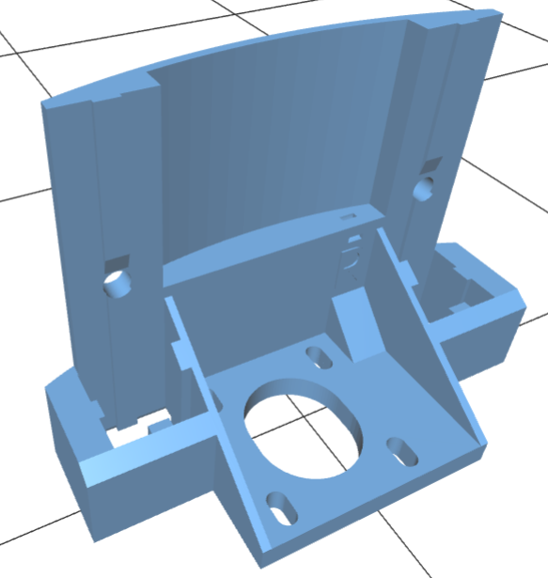
[picture p56: figure]

Z-motor-right.stl

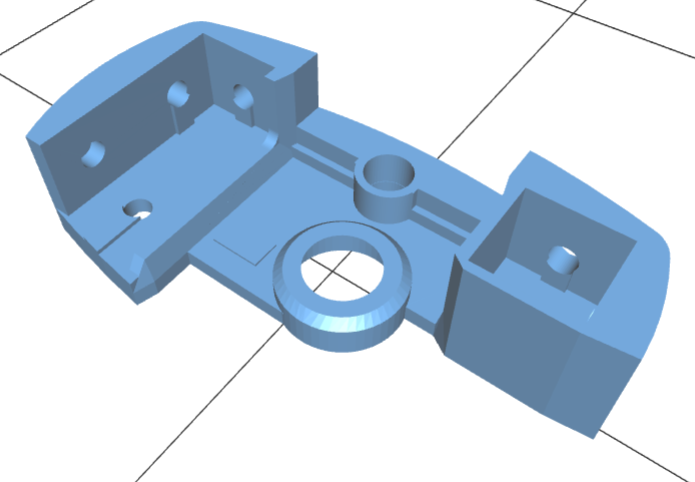
[picture p57: figure]

Z-top-left.stl

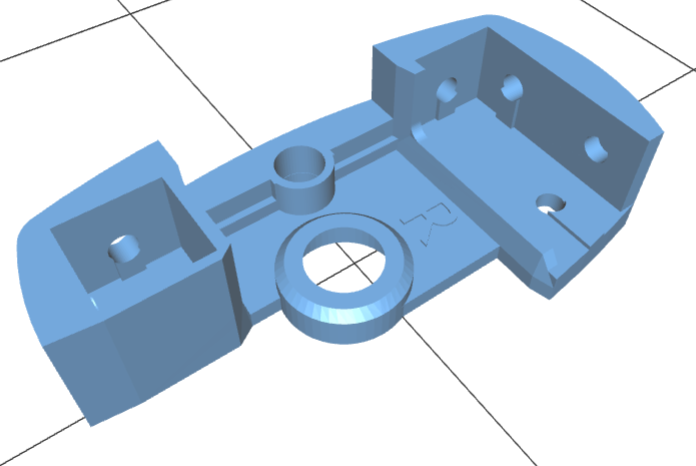
[picture p58: figure]

Z-top-right.stl


Z-rack.stl


Coupler-5x8.stl (2)
