smdawson/Wilson2/doc/x-axis-assembly-notes.odt

# Wilson II X-axis assembly notes

Step by step notes

1. insert the linear bearings into the X ends and X carriage

2. Attach the lead screw nuts to each x end using two M3 x 14mm screws and nuts on each.

3. Assemble the 624 bearing with the printed belt guides and the X tensioner (or use a preassembled idler pulley with the alternate x tensioner) using a M4x20mm screw and hex nut. Insert a M3 nut into the X tensioner and thread M3x30mm screw in just until through nut. Install the X tensioner in the X idler end, using a M4 x 20mm screw to secure the tensioner.

4. Wire each endstop (if not prewired). Z endstop will need about 70cm of wire, the X axis only needs about half that.

5. attach one endstop switch to the X motor end using a miniature zip tie (or two M2 screws and nuts). Secure with a zip tie through the slot provided on the X motor end.

6. Attach one endstop to the Z pinion using a miniaturej zip tie. Secure wires using another zip tie through the small loop provided on the Z pinion to prevent strain on the wire.

7. Slide the Z rack through the slot on the bottom of the X carriage, align the Z pinion, and secure pinion using a M3x20mm screw and hex nut.

8. Attach the extension springs to the Z pinion. On each side of the X carriage, attach an extension spring with a M3x10mm screw into the holes provided. Tighten M3x10mm screws just until bottomed out. Thread a M3x40mm screw through one extension spring, then through the Z pinion, and attach the other extension spring to the other side of the M3x40mm screw. Attach a M3 locknut and tighten just until the screw is through the locknut.

9. Install GT2 pulley onto the stepper motor and attach the stepper motor to the X motor end using three M3x14mm screws.

10. Slide each 10mm smooth rod into one of the X ends, then slide X carriage onto rods, followed by the other X end.

Do not attach the timing belt yet (wait until you've mounted the X axis to the frame).

Parts needed:

Description | Quantity
X Idler end | 1
X Motor end | 1
X tensioner | 1
X Carriage | 1
Z Rack | 1
Z Pinion | 1
624 bearing belt guide (2 pieces) | 1
NEMA17 stepper motor | 1
GT2 timing pulley | 1
624 bearing | 1
Lead screw nut | 2
Endstop switch | 2
LM10UU linear bearing | 8
370mm 10mm smooth rod | 2
Miniature nylon zip ties (2mm width) | 6
M3 x 14mm screw | 7
M3 x 40mm screw | 1
M3 x 30mm screw | 1
M3 x 20mm screw | 1
M3 x 10mm screw | 2
M4 x 20mm screw | 2
M3 nex nut | 5
M3 locknut | 1
M4 locknut | 1
M4 hex nut | 1
0.625” extension spring | 2

Tools needed

Phillips screwdriver

Allen keys

Plier
