smdawson/Wilson2/doc/wilson-ii-partsguide-nobeltguides.pdf

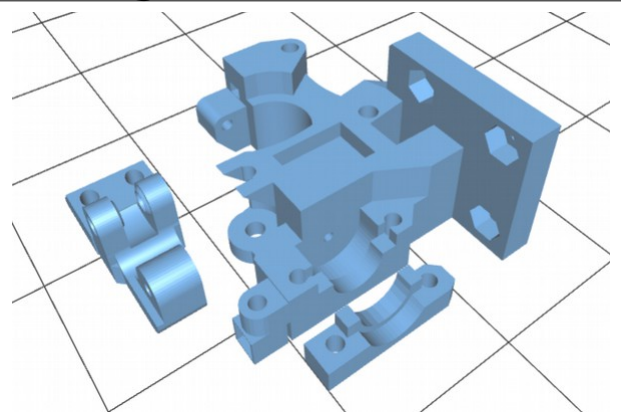
[picture p59: figure]

Wilson II Printed parts guide

Extruder-direct-drive.stl (3 pieces)

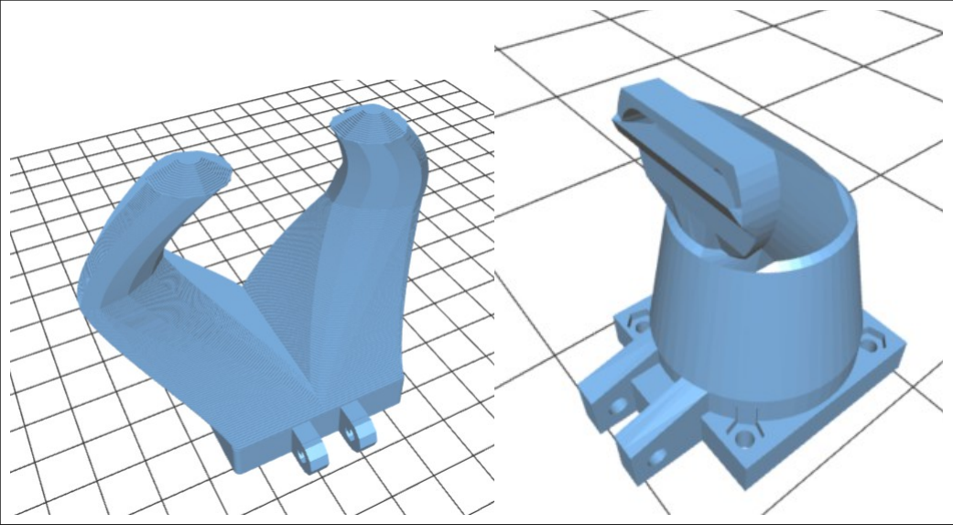
[picture p60: figure]

Fanduct-e3dlite6.stl or Fanduct-e3dlite6-alt.stl

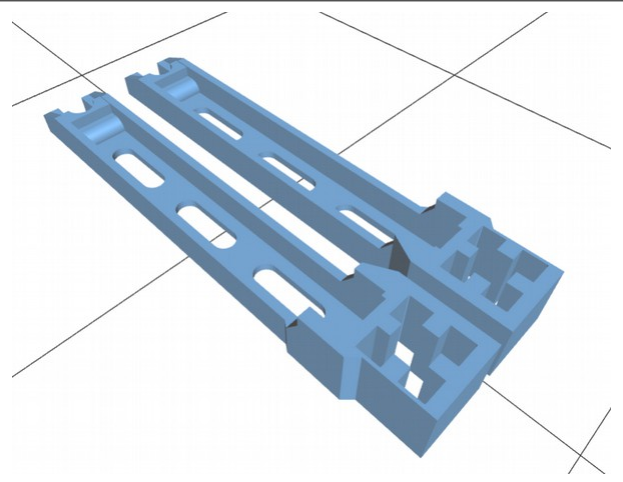
[picture p61: figure]

Filament-mount.stl (2 pieces)

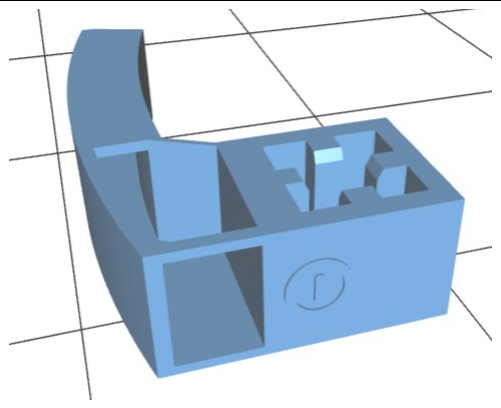
[picture p62: figure]

Power-switch-mount.stl

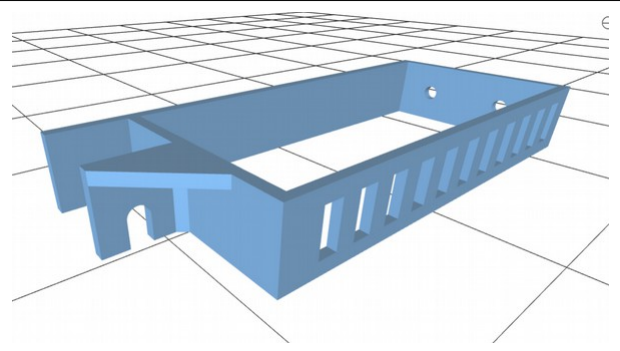
[picture p63: figure]

Psu-mount.stl (2)

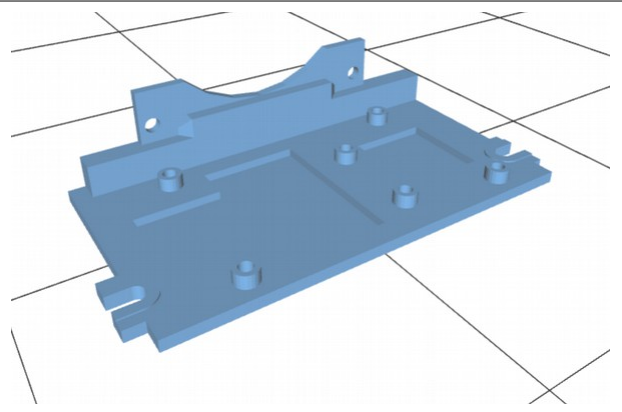
[picture p64: figure]

Ramps-mount.stl

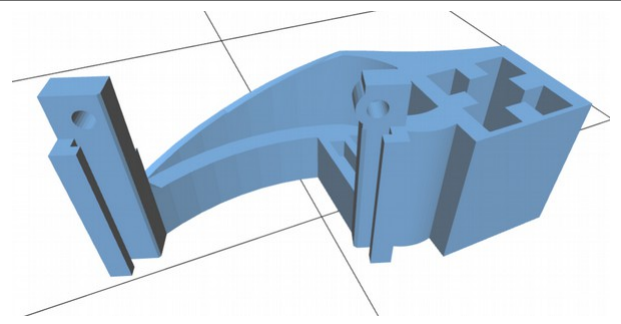
[picture p65: figure]

Smartlcd-mount.stl

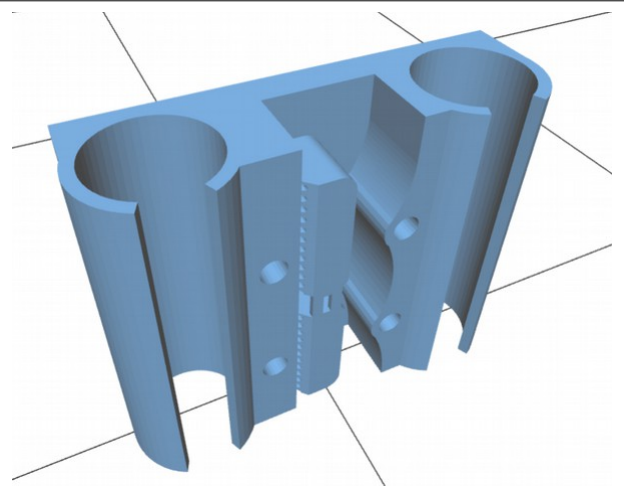
[picture p66: figure]

X-carriage.stl

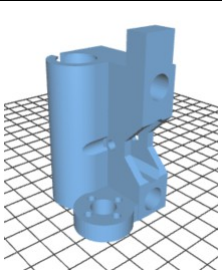
[picture p67: figure]

X-end-idler.stl

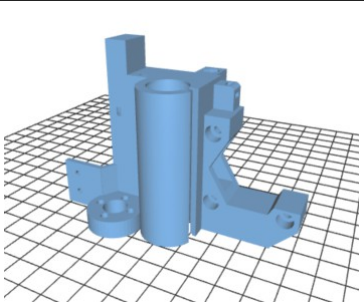
[picture p68: figure]

X-end-motor.stl

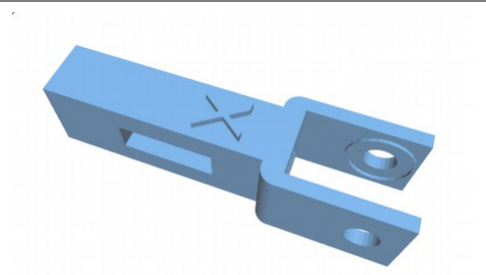
[picture p69: figure]

X-tensioner.stl

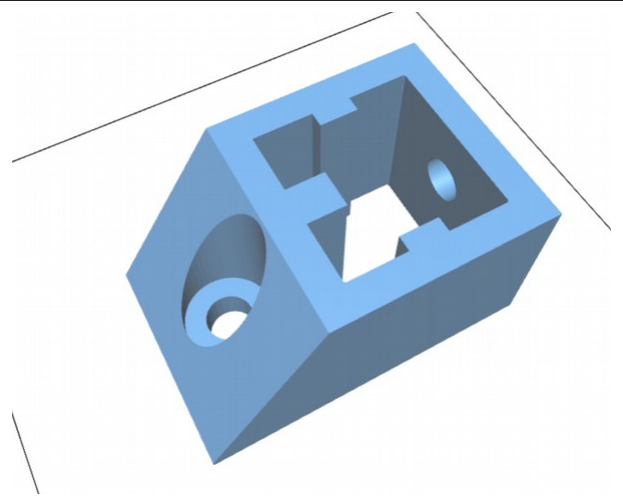
[picture p70: figure]

Y-brace.stl (4)

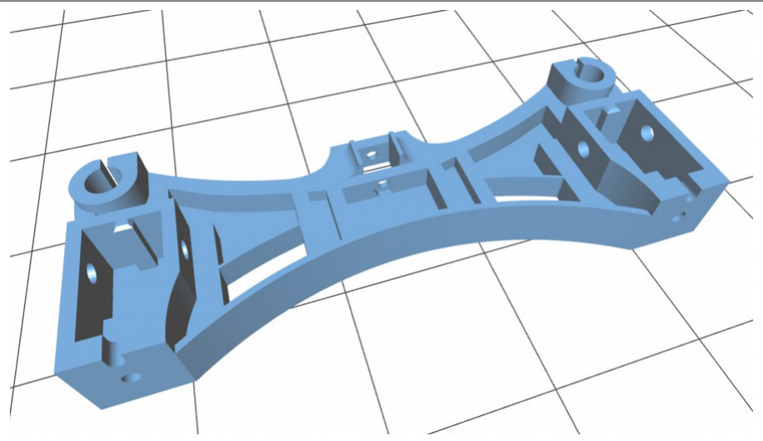
[picture p71: figure]

Y-idler.stl

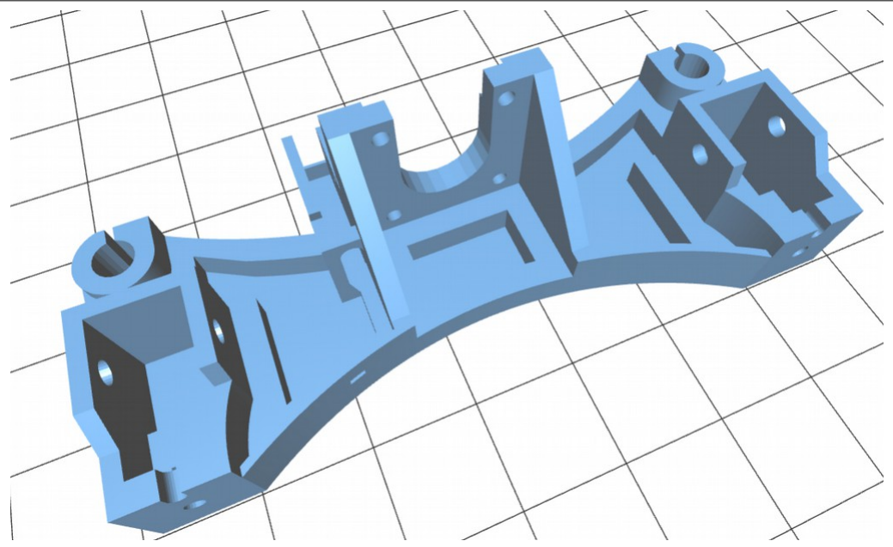
[picture p72: figure]

Y-motor.stl

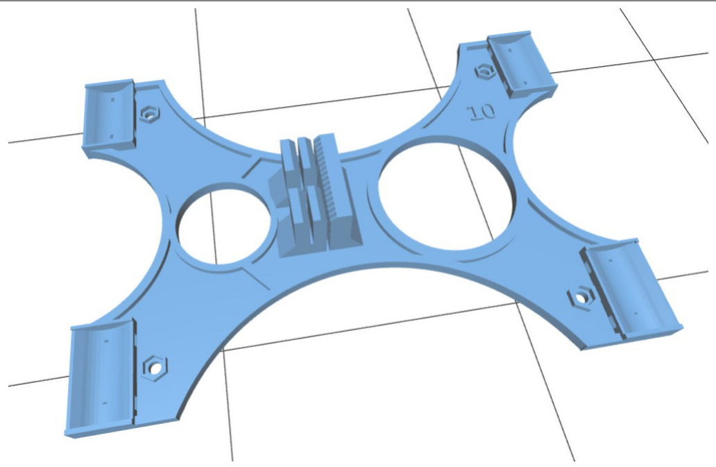
[picture p73: figure]

Y-table-10.stl

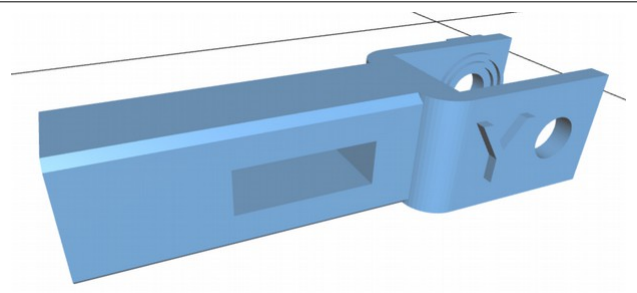
[picture p74: figure]

Y-tensioner.stl

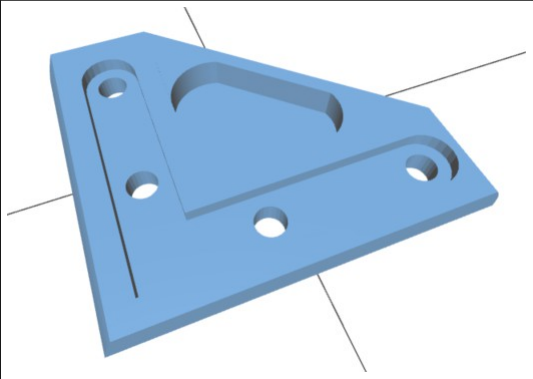
[picture p75: figure]

Z-lower-brace-1.stl (2)

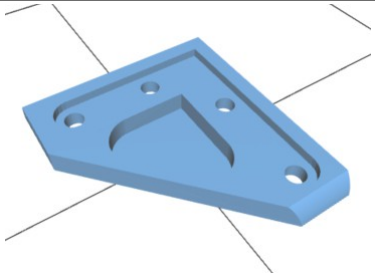
[picture p76: figure]

Z-lower-brace-2.stl (2)

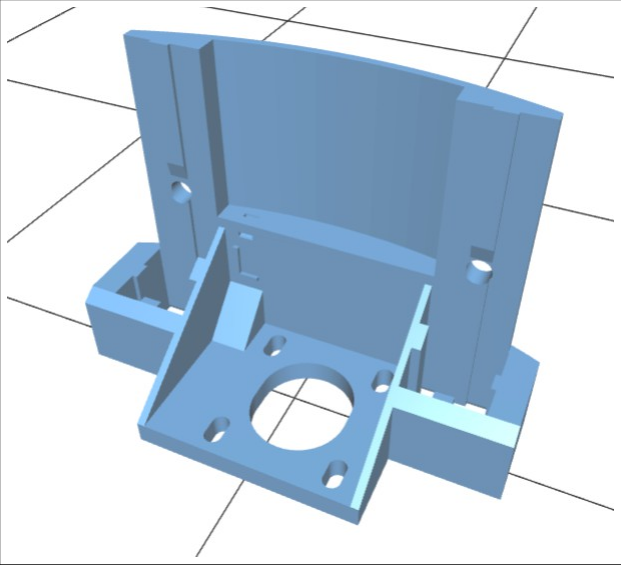
[picture p77: figure]

Z-motor-left.stl

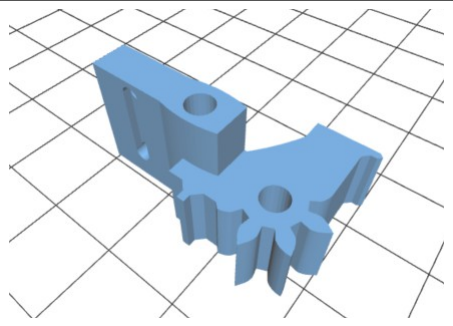
[picture p78: figure]

Z-pinion.stl

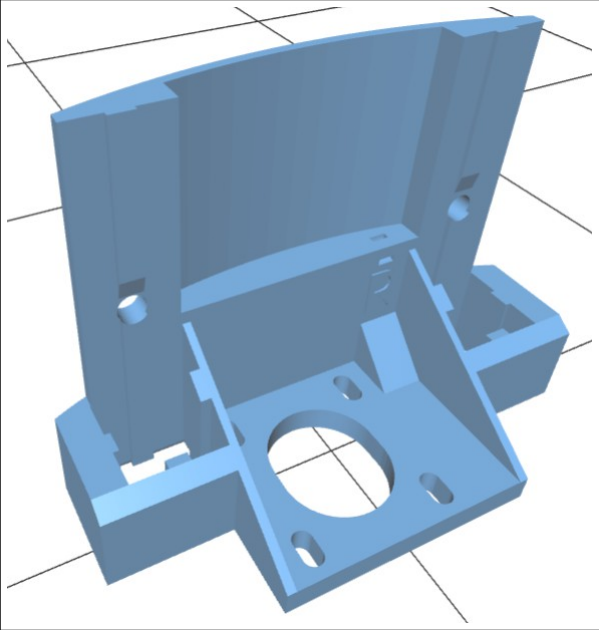
[picture p79: figure]

Z-motor-right.stl

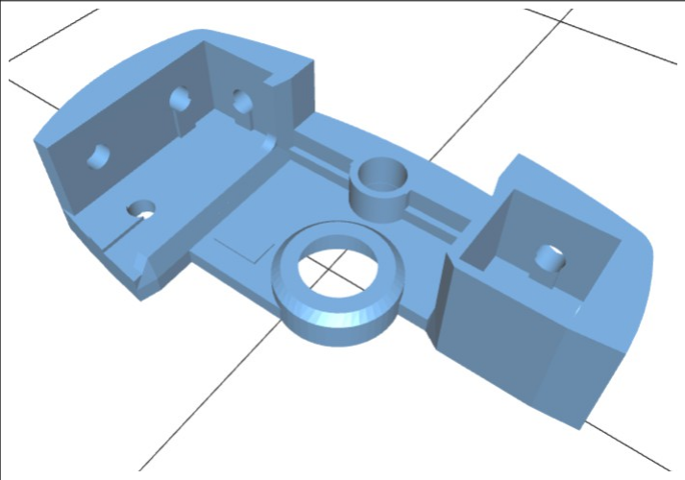
[picture p80: figure]

Z-top-left.stl

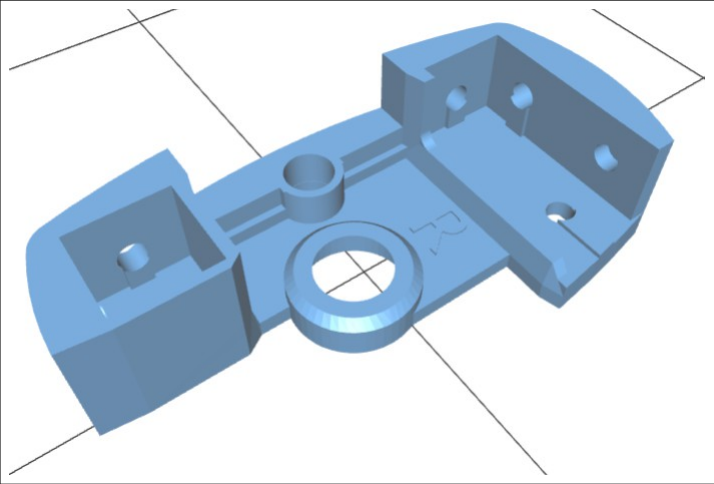
[picture p81: figure]

Z-top-right.stl

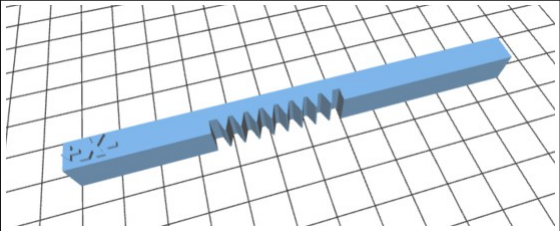
[picture p82: figure]

Z-rack.stl
