smdawson/Wilson2/(commit log)

2016-02-12 Added My BOM
    [My_WilsonII_BOM.xlsx]
2016-02-12 Added Ruler and write for scad
    [BlackRose.dxf, Letters.dxf, TestFont.scad, TestSurfaceText.scad, TestWrite.scad, TestWriteCube.scad, TestWriteCylinder.scad, TestWriteSphere.scad]
2016-02-15 BOM Update
    [My_WilsonII_BOM.xlsx]
2016-02-17 Updated BOM
    [My_WilsonII_BOM.xlsx]
2016-02-17 Added Bed dxf drawing
    [wilson-bed-2030-lc.dxf]
2016-02-22 Update to BOM
    [My_WilsonII_BOM.xlsx]
2016-03-01 added dimension layer to dxf, updated bom
    [#wilson-bed-2030-lc.dxf, My_WilsonII_BOM.xlsx]
